AungpaoK/EmbeddedProj/docs/chapter2.md

# บทที่ 2 แนวคิด ทฤษฎี และเอกสารที่เกี่ยวข้อง

บทนี้นำเสนอแนวคิดและหลักการทางวิศวกรรมที่ใช้เป็นพื้นฐานของหุ่นยนต์ส่งอาหาร ตั้งแต่สถาปัตยกรรมระบบฝังตัว การรับสัญญาณจากอุปกรณ์ การควบคุมมอเตอร์ และการประมาณการเคลื่อนที่ ไปจนถึงการตรวจสิ่งกีดขวาง การสื่อสาร และการจัดการลำดับภารกิจ เนื้อหาแต่ละส่วนอธิบายทั้งหลักการทั่วไปและความสัมพันธ์กับการออกแบบที่ปรากฏในฮาร์ดแวร์และซอฟต์แวร์ของโครงงาน เพื่อให้เห็นเหตุผลของการแบ่งหน้าที่และข้อจำกัดของวิธีที่เลือกใช้ รายละเอียดการประกอบ การพัฒนาโปรแกรม และผลการทดสอบเชิงปริมาณนำเสนอในบทที่ 3 และบทที่ 4 ตามลำดับ

## 2.1 ระบบฝังตัวและสถาปัตยกรรมของหุ่นยนต์

### 2.1.1 แนวคิดของระบบฝังตัว

ระบบฝังตัว (embedded system) เป็นระบบคอมพิวเตอร์ที่ออกแบบให้ทำหน้าที่เฉพาะภายใต้ข้อจำกัดของฮาร์ดแวร์และสภาพแวดล้อม เช่น การอ่านค่าจากเซนเซอร์ การประมวลผลตามเงื่อนไข และการสั่งงานอุปกรณ์เอาต์พุต การออกแบบระบบลักษณะนี้จึงพิจารณามากกว่าความถูกต้องของผลลัพธ์ โดยต้องคำนึงถึงเวลาตอบสนอง ความสม่ำเสมอของการทำงาน หน่วยความจำ พลังงาน และการจัดการความผิดพลาดด้วย งานบางประเภทมีข้อกำหนดด้านเวลาจริง (real-time constraint) กล่าวคือ ผลลัพธ์ต้องถูกต้องและเกิดขึ้นภายในเวลาที่กำหนด การพลาดกำหนดเวลาอาจทำให้คุณภาพการควบคุมลดลง แม้ค่าที่คำนวณได้จะถูกต้องก็ตาม

ไมโครคอนโทรลเลอร์รวมหน่วยประมวลผล หน่วยความจำ และวงจรต่อพ่วง เช่น ขารับส่งสัญญาณดิจิทัล (GPIO) ตัวนับเวลา ตัวสร้างสัญญาณ PWM วงจรขัดจังหวะ (interrupt) และพอร์ตสื่อสาร ไว้ในชิปเดียว Arduino Uno R3 ซึ่งใช้ ATmega328P มีทรัพยากรเหล่านี้สำหรับเชื่อมต่ออุปกรณ์และควบคุมงานที่ทำซ้ำตามคาบ [1], [2] ข้อเด่นของแนวทางนี้คือสามารถตอบสนองต่อสัญญาณ encoder และอัปเดตคำสั่งมอเตอร์โดยไม่ต้องผ่านระบบปฏิบัติการทั่วไป ขณะเดียวกันยังต้องจัดสรรขา I/O หน่วยความจำ และเวลาประมวลผลอย่างระมัดระวัง

คอมพิวเตอร์บอร์ดเดี่ยว (single-board computer: SBC) เช่น Raspberry Pi มีทรัพยากรประมวลผลและระบบปฏิบัติการที่เอื้อต่อการทำงานระดับสูง เช่น การจัดการภารกิจ ส่วนติดต่อผู้ใช้ การสื่อสารผ่านเครือข่าย และการประมวลผลข้อมูลจากเซนเซอร์ ระบบปฏิบัติการทั่วไปช่วยให้พัฒนาซอฟต์แวร์ได้สะดวก แต่ไม่ได้รับประกันความหน่วงหรือเวลาตอบสนองแบบกำหนดแน่นอนในทุกสถานการณ์ ด้วยเหตุนี้ การแบ่งงานควบคุมมอเตอร์ที่ต้องอัปเดตต่อเนื่องไปยังไมโครคอนโทรลเลอร์ และให้งานจัดการภารกิจอยู่บน SBC จึงช่วยแยกขอบเขตการทำงานและลดการพึ่งพากันระหว่างซอฟต์แวร์แต่ละระดับ [2]

### 2.1.2 การแบ่งหน้าที่ในโครงงาน

สถาปัตยกรรมหลักประกอบด้วย Raspberry Pi 4 Model B หน่วยความจำ 4 GB และ Arduino Uno R3 หนึ่งบอร์ด Arduino อ่าน encoder และ keypad, ควบคุมมอเตอร์ซ้ายและขวาผ่านวงจรขับ L298N และสั่งแสดงลูกศรเลี้ยวบน LED Matrix ขนาด 32×8 ส่วน Raspberry Pi ทำหน้าที่รัน POS/Kiosk จัดการสถานะภารกิจและ waypoint รับข้อมูล LiDAR และแลกเปลี่ยนคำสั่งหรือข้อมูลสถานะกับ Arduino ผ่าน USB Serial โดยระบบซอฟต์แวร์รองรับทั้ง backend แบบ Serial โดยตรงและ backend ที่ส่งข้อมูลผ่าน ROS 2

การแยกชั้นดังกล่าวทำให้การควบคุมความเร็วล้อ การอ่าน encoder และการสั่งเอาต์พุตอยู่ใกล้ฮาร์ดแวร์ ขณะที่การวางลำดับงานและการติดต่อผู้ใช้อยู่ในซอฟต์แวร์ระดับสูง จอสัมผัสเป็นช่องทางหลักของ POS/Kiosk และ keypad 4×4 เป็นช่องทางรับคำสั่งทางเลือกที่ปรับข้อมูล draft ชุดเดียวกัน ในระบบที่ระบุในเอกสารออกแบบปัจจุบัน ไม่มี Arduino ชั้นวางตัวที่สองหรือเซนเซอร์ IR สำหรับตรวจอาหารโดยตรง การต่อกับชุดชั้นวางเสริมมีทางเลือกในซอฟต์แวร์ แต่ไม่ควรตีความเป็นส่วนหนึ่งของฮาร์ดแวร์ที่ใช้งานอยู่เสมอไป รายละเอียดอุปกรณ์และจุดเชื่อมต่ออ้างอิงได้จาก [แบบออกแบบฮาร์ดแวร์](design.md), [firmware ควบคุมการเคลื่อนที่](../src/Arduino_1_Motion/Arduino_1_Motion.ino) และ [จุดเริ่มต้นระบบหลัก](../src/main.py)

## 2.2 อินพุต เอาต์พุต และการควบคุมมอเตอร์

### 2.2.1 GPIO, interrupt และ PWM

ขา GPIO (general-purpose input/output) ใช้รับหรือส่งสถานะดิจิทัล เช่น อ่านปุ่ม กำหนดทิศทางการหมุน หรือควบคุมสัญญาณ enable การอ่านอินพุตแบบวนตรวจ (polling) เหมาะกับสัญญาณที่เปลี่ยนไม่บ่อย แต่ encoder อาจสร้างพัลส์ต่อเนื่องในขณะที่โปรแกรมทำงานส่วนอื่น วงจร interrupt ช่วยแจ้งให้หน่วยประมวลผลจัดการเหตุการณ์ที่ขาอินพุตเปลี่ยนแปลงโดยไม่ต้องรอรอบการวนตรวจถัดไป จึงลดโอกาสพลาดพัลส์เมื่อเลือกใช้อย่างเหมาะสม [2]

โครงงานใช้ Pin Change Interrupt บนพอร์ต C ของ ATmega328P สำหรับติดตาม encoder โดยนับขอบขาขึ้นของเฟส A และอ่านระดับเฟส B เพื่อระบุทิศทาง การนับใน interrupt ทำให้ตัวแปร tick ถูกเปลี่ยนจากบริบทการทำงานที่ต่างจากลูปหลัก ดังนั้นการคัดลอกค่าตัวนับที่มีขนาดหลายไบต์ต้องป้องกันการอ่านระหว่างที่ interrupt กำลังแก้ค่า firmware จึงอ่านค่า tick โดยปิด interrupt ชั่วคราวขณะคัดลอกข้อมูล แล้วเปิดกลับทันที

การปรับความกว้างพัลส์ (pulse-width modulation: PWM) คือการปรับสัดส่วนเวลาที่สัญญาณอยู่ระดับสูงต่อหนึ่งคาบ หรือ duty cycle เพื่อควบคุมกำลังเฉลี่ยที่ส่งไปยังโหลด ฟังก์ชัน `analogWrite()` ของ Arduino สร้างสัญญาณ PWM บนขาที่รองรับ ไม่ได้สร้างแรงดันแอนะล็อกต่อเนื่องโดยตรง [3] ในโครงงาน PWM ใช้ควบคุมขา enable ของวงจรขับ ส่วนขาดิจิทัลแยกกันใช้กำหนดขั้วและทิศทางของมอเตอร์

### 2.2.2 มอเตอร์กระแสตรงและวงจร H-bridge

มอเตอร์กระแสตรง (direct-current motor: DC motor) เปลี่ยนพลังงานไฟฟ้าเป็นการหมุนของเพลา ความเร็วและแรงบิดที่เกิดขึ้นสัมพันธ์กับแรงดัน กระแส โหลดเชิงกล และคุณสมบัติของมอเตอร์ การกลับขั้วแรงดันที่ขั้วมอเตอร์ทำให้เปลี่ยนทิศการหมุน แต่ขาไมโครคอนโทรลเลอร์ไม่สามารถจ่ายกระแสให้มอเตอร์โดยตรงได้ จึงต้องมีวงจรขับกำลังเป็นตัวกลาง

วงจร H-bridge ใช้ชุดสวิตช์จัดเส้นทางกระแสเพื่อเลือกขั้วแรงดันที่จ่ายให้มอเตอร์ จึงรองรับการหมุนได้สองทิศทาง วงจร L298 เป็นวงจรขับแบบ dual full-bridge สำหรับโหลดเหนี่ยวนำ เช่น มอเตอร์ DC [4] ในระบบนี้ Arduino ส่งสัญญาณกำหนดทิศทางและ PWM ไปยัง L298N เพื่อควบคุมล้อซ้ายและขวาแยกกัน การประเมินกระแสที่รองรับ ความร้อน และแรงดันตกคร่อมของโมดูลต้องอ้างอิง datasheet และการต่อใช้งานจริง ไม่ควรอนุมานจากชื่อโมดูลหรือค่าพิกัดของชิปเพียงอย่างเดียว

### 2.2.3 Encoder และการวัดความเร็ว

Rotary encoder แปลงการหมุนของเพลาเป็นพัลส์ดิจิทัล เมื่อทราบจำนวนพัลส์ต่อรอบและนับการเปลี่ยนแปลงในช่วงเวลาที่กำหนด จะประมาณได้ทั้งระยะทางและความเร็วเชิงเส้นของล้อ สำหรับล้อรัศมี (R) และ encoder ที่ให้ความละเอียด (N) tick ต่อรอบ ระยะทางต่อ tick โดยประมาณเป็น

\[
\Delta s_{tick}=\frac{2\pi R}{N}
\]

หากจำนวน tick เปลี่ยนไป \(\Delta n\) ในช่วงเวลา \(\Delta t\) ระยะทางและความเร็วเฉลี่ยของล้อประมาณได้จาก

\[
\Delta s=\Delta n\,\Delta s_{tick},\qquad v\approx\frac{\Delta s}{\Delta t}
\]

โครงงานกำหนดรัศมีล้อ \(R=0.065\,\mathrm{m}\) และความละเอียด \(N=1920\,\mathrm{tick/rev}\) จึงได้ระยะทางเชิงทฤษฎีประมาณ \(2.13\times10^{-4}\,\mathrm{m/tick}\) หรือประมาณ 0.213 mm ต่อ tick [6], [11] ค่านี้เป็นความสัมพันธ์จากพารามิเตอร์ที่กำหนด ไม่ใช่ผลการวัดความแม่นยำของตัวรถ เนื่องจากค่าจริงยังขึ้นกับความละเอียด encoder การกำหนดขอบสัญญาณใน firmware และลักษณะการสัมผัสระหว่างล้อกับพื้น

### 2.2.4 การควบคุมความเร็วแบบป้อนกลับ

ระบบควบคุมแบบป้อนกลับ (feedback control) นำค่าที่วัดได้กลับมาเปรียบเทียบกับค่าเป้าหมาย แล้วใช้ความคลาดเคลื่อนในการปรับคำสั่งควบคุม ตัวควบคุม PID ประกอบด้วยส่วนสัดส่วน (proportional: P) ส่วนอินทิกรัล (integral: I) และส่วนอนุพันธ์ (derivative: D) สมการในโดเมนเวลาต่อเนื่องเขียนโดยย่อได้ดังนี้ [5]

\[
u(t)=K_p e(t)+K_i\int_0^t e(\tau)\,d\tau+K_d\frac{de(t)}{dt},\qquad e(t)=r(t)-y(t)
\]

โดย \(r(t)\) คือค่าเป้าหมาย \(y(t)\) คือค่าที่วัดได้ และ \(u(t)\) คือคำสั่งควบคุม ส่วน P ตอบสนองต่อความคลาดเคลื่อนปัจจุบัน ส่วน I สะสมความคลาดเคลื่อนตามเวลา และส่วน D พิจารณาอัตราการเปลี่ยนแปลงของความคลาดเคลื่อน การนำ PID ไปใช้บนไมโครคอนโทรลเลอร์เป็นการคำนวณแบบไม่ต่อเนื่อง ณ เวลาสุ่มตัวอย่าง \(T_s\) จึงประมาณอินทิกรัลด้วยผลรวมของตัวอย่างและประมาณอนุพันธ์ด้วยผลต่างระหว่างตัวอย่าง การจำกัดเอาต์พุตและผลรวมอินทิกรัลช่วยลดปัญหา integral windup เมื่อคำสั่งขับถึงขีดจำกัด

firmware ควบคุมความเร็วล้อซ้ายและขวาด้วย PID แยกกัน โดยอัปเดตวงควบคุมประมาณทุก 20 ms หรือ 50 Hz ความเร็วที่คำนวณจาก tick ถูกกรองแบบเอ็กซ์โพเนนเชียลก่อนป้อนกลับ และส่วนอนุพันธ์คำนวณจากการเปลี่ยนแปลงของความเร็วที่วัดได้ เฟิร์มแวร์ยังเพิ่ม feed-forward ตามความเร็วเป้าหมาย และจำกัดผลรวมอินทิกรัลไว้ในช่วงที่กำหนด แนวทางนี้ผสานการชดเชยจากแบบจำลองอย่างง่ายกับการแก้ความคลาดเคลื่อนจากข้อมูล encoder โดยยังต้องอาศัยการตั้งค่าที่เหมาะกับมอเตอร์และโหลดจริง

เมื่อนำหลักการดังกล่าวมาเขียนในรูปแบบไม่ต่อเนื่อง ให้ \(T_s\) เป็นช่วงเวลาสุ่มตัวอย่าง \(v_{raw}[k]\) เป็นความเร็วที่คำนวณจาก tick และ \(v_f[k]\) เป็นความเร็วหลังการกรอง การคำนวณใน firmware สรุปได้โดยประมาณดังนี้

\[
v_f[k]=0.85v_f[k-1]+0.15v_{raw}[k],\quad
e[k]=r[k]-v_f[k]
\]
\[
I[k]=\operatorname{clip}(I[k-1]+e[k]T_s,-2,2),\quad
D_v[k]=\frac{v_f[k]-v_f[k-1]}{T_s}
\]
\[
u[k]=\frac{r[k]}{v_{cruise}}u_{ff}+K_p e[k]+K_i I[k]-K_dD_v[k]
\]

สมการนี้แสดงให้เห็นว่าอนุพันธ์ในโค้ดคำนวณจากความเร็วที่วัดได้ ไม่ได้คำนวณจากผลต่างของ setpoint โดยตรง ส่วนเอาต์พุตสุดท้ายถูกจำกัดให้อยู่ในช่วง PWM ที่ฮาร์ดแวร์รองรับ และมีค่าเอาต์พุตขั้นต่ำเมื่อมีคำสั่งเคลื่อนที่ เพื่อให้คำสั่งไม่หายไปเมื่อผลคำนวณต่ำกว่าค่าที่กำหนด ค่า gain, feed-forward และขีดจำกัดเป็นค่าการตั้งค่าของ firmware ไม่ใช่ค่าทั่วไปที่รับประกันสมรรถนะกับมอเตอร์ทุกชนิด

ขณะเคลื่อนที่ตรง firmware ใช้ความต่างของระยะสะสมระหว่างล้อเป็น wheel synchronization เพื่อปรับ setpoint ของแต่ละล้อและลดการเบี่ยงเบนจากเส้นตรง นอกจากนี้ยังเพิ่มความเร็วเป้าหมายเป็นขั้นในช่วงเริ่มต้นและลดความเร็วเมื่อใกล้ระยะปลายทาง ส่วนการป้องกัน stall จะเพิ่ม PWM เป็นขั้นเมื่อมี setpoint แต่ encoder ไม่แสดงการเคลื่อนที่ และยกสถานะ fault หากไม่มีการเคลื่อนที่ต่อเนื่องเกินช่วงเวลาที่กำหนด กลไกเหล่านี้เป็นส่วนหนึ่งของการควบคุมและการจัดการความผิดปกติใน firmware ไม่ใช่หลักฐานยืนยันความแม่นยำหรือความปลอดภัยของระบบ ผลเชิงปริมาณต้องรายงานจากการทดสอบในบทที่ 4

## 2.3 การเคลื่อนที่แบบ Differential Drive และ Odometry

หุ่นยนต์แบบ Differential Drive ขับเคลื่อนด้วยล้อสองข้างที่ควบคุมความเร็วแยกจากกัน โดยล้อทั้งสองมีแกนหมุนร่วมกันและล้อประคองช่วยพยุงตัวรถ ให้ \(v_L\) และ \(v_R\) เป็นความเร็วเชิงเส้นของล้อซ้ายและขวา และให้ \(b\) เป็นระยะระหว่างศูนย์กลางล้อขับ ความเร็วเชิงเส้นของจุดกึ่งกลางรถ \(v\) และความเร็วเชิงมุมรอบแกนตั้ง \(\omega\) เป็น [11]

\[
v=\frac{v_R+v_L}{2},\qquad
\omega=\frac{v_R-v_L}{b}
\]

เมื่อความเร็วล้อทั้งสองเท่ากัน รถจะเคลื่อนที่ตรงโดยประมาณ เมื่อความเร็วแตกต่างกันรถจะเคลื่อนที่เป็นส่วนโค้ง และเมื่อกำหนดให้ล้อหมุนสวนทางกันด้วยขนาดใกล้เคียงกัน รถจะหมุนรอบตัวเองได้ แบบจำลองนี้ช่วยแปลงคำสั่งการเคลื่อนที่ของรถเป็นความเร็วล้อ และใช้ย้อนคำนวณการเปลี่ยนตำแหน่งจาก encoder อย่างไรก็ตาม แบบจำลองเป็นแบบจำลองเชิงจลนศาสตร์ จึงไม่ได้อธิบายแรง มวล หรือพลวัตของมอเตอร์โดยละเอียด

Odometry คือการประมาณตำแหน่งและทิศทางจากการเคลื่อนที่สะสมของล้อ ในช่วงเวลาหนึ่งให้การเคลื่อนที่ของล้อซ้ายและขวาเป็น \(\Delta s_L\) และ \(\Delta s_R\) จะได้การเคลื่อนที่ของจุดกึ่งกลางและการเปลี่ยน heading ดังนี้

\[
\Delta s=\frac{\Delta s_R+\Delta s_L}{2},\qquad
\Delta\theta=\frac{\Delta s_R-\Delta s_L}{b}
\]

การอินทิเกรตตำแหน่งด้วยวิธี midpoint ประมาณได้จาก

\[
x_{k+1}=x_k+\Delta s\cos(\theta_k+\Delta\theta/2),\quad
y_{k+1}=y_k+\Delta s\sin(\theta_k+\Delta\theta/2),\quad
\theta_{k+1}=\theta_k+\Delta\theta
\]

ในโครงงาน Raspberry Pi ใช้ tick ซ้ายและขวาที่รับจาก Arduino เพื่อคำนวณ pose โดยกำหนดค่ารัศมีล้อ \(R=0.065\,\mathrm{m}\), ระยะห่างล้อ \(b=0.343\,\mathrm{m}\) และความละเอียด \(N=1920\,\mathrm{tick/rev}\) ใน configuration [6], [11] เส้นทางภารกิจใช้ waypoint ที่กำหนดตำแหน่งสถานี ทางแยก และโต๊ะไว้ล่วงหน้า จากนั้นใช้ตำแหน่งและ heading จาก odometry เพื่อควบคุมช่วงทางและการเลี้ยว วิธีนี้มีโครงสร้างตรงไปตรงมาและเหมาะกับเส้นทางที่ทราบรูปแบบ แต่ไม่เทียบเท่ากับการรู้ตำแหน่งสัมบูรณ์ของรถ

กรอบพิกัดของเส้นทางกำหนดสถานีเริ่มต้นเป็น \((0,0)\) และทิศออกจากสถานีเป็นแกน \(+X\) ค่าเริ่มต้นใน configuration กำหนดทางแยกที่ \((2.0,0)\) m และกำหนดตำแหน่งโต๊ะ 1 กับโต๊ะ 2 ที่ \((2.0,+0.6)\) m และ \((2.0,-0.6)\) m ตามลำดับ [config.py](../src/config.py) ตัวควบคุม waypoint ใช้เป้าหมายเหล่านี้เพื่อแยกการเดินทางเป็นช่วงตรงและช่วงปรับ heading โดยใช้ pose ปัจจุบันจาก odometry เป็น feedback เส้นทางจึงเป็นเส้นทางที่ระบุไว้ล่วงหน้า มิใช่การค้นหาเส้นทางอิสระจากแผนที่ในทุกครั้งที่เดินทาง

เนื่องจาก odometry เป็นการคำนวณแบบ dead reckoning ความคลาดเคลื่อนของแต่ละช่วงจะสะสมไปตามระยะทาง ความคลาดเคลื่อนเชิงระบบที่สำคัญ ได้แก่ เส้นผ่านศูนย์กลางล้อซ้ายและขวาไม่เท่ากัน และระยะห่างล้อเชิงประสิทธิผลไม่ตรงกับค่าที่ใช้คำนวณ ส่วนความคลาดเคลื่อนจากการลื่นไถล การกระจายน้ำหนัก และพื้นผิวมีลักษณะเปลี่ยนแปลงตามสภาพการทำงาน งานของ Borenstein และ Feng เสนอวิธีวัดและแก้ความคลาดเคลื่อนเชิงระบบจาก wheelbase และขนาดล้อ จึงสนับสนุนความจำเป็นของการสอบเทียบพารามิเตอร์กับตัวรถจริง [6]

ในเส้นทางซอฟต์แวร์ ROS 2 มีการตั้งค่าปัจจัยปรับระยะล้อเฉพาะการคำนวณ odometry ใน bridge โดยค่าเริ่มต้นของ `ODOM_TRACK_WIDTH_FACTOR` คือ 1.185 ขณะที่ค่าระยะห่างล้อที่ใช้แปลงคำสั่งความเร็วล้อยังคงแยกจากพารามิเตอร์ดังกล่าว [../src/slam_bridge.py](../src/slam_bridge.py) ดังนั้นค่าปรับนี้ควรอธิบายในฐานะการชดเชย odometry ในเส้นทาง ROS ไม่ใช่การเปลี่ยนระยะทางกายภาพของล้อหรือค่าที่ใช้ในทุก backend

แผนที่ร้านอาหารที่ใช้แสดงตำแหน่งและเส้นทางไม่ใช่แหล่ง localization ของ waypoint controller ตามจุดเชื่อมต่อใน [main.py](../src/main.py) ส่วน `slam_bridge.py` เป็น bridge สำหรับส่งข้อมูล encoder เป็น `/odom`, รับคำสั่ง `/cmd_vel` และเชื่อมข้อมูล LiDAR/TF สำหรับการทดสอบที่เกี่ยวข้องกับ ROS 2 และ SLAM การทำงานนำทางของภารกิจจึงควรอธิบายตาม waypoint และ encoder odometry เป็นหลัก ไม่กล่าวว่าใช้ SLAM, A* หรือ DWA เป็นระบบนำทางหลักหากการทดลองนั้นไม่ได้เปิดใช้งานจริง

## 2.4 เซนเซอร์และการตรวจจับสิ่งกีดขวาง

### 2.4.1 Keypad 4×4 และตัวขยายพอร์ต PCF8574

Keypad แบบเมทริกซ์จัดปุ่มเป็นแถวและคอลัมน์เพื่ออ่านปุ่มหลายปุ่มโดยใช้จำนวนสายสัญญาณน้อยกว่าการต่อปุ่มแยกแต่ละปุ่ม ตัวขยายพอร์ต PCF8574 ทำหน้าที่เป็นอินพุต/เอาต์พุตดิจิทัล 8 บิตที่ควบคุมผ่านบัส I²C ซึ่งมีสายสัญญาณข้อมูล SDA และสัญญาณนาฬิกา SCL [10] วิธีนี้ลดจำนวนขา GPIO ที่ใช้กับ keypad และเปิดโอกาสให้ไมโครคอนโทรลเลอร์สงวนขาอื่นไว้สำหรับ encoder และมอเตอร์

โครงงานต่อ SDA และ SCL ของ PCF8574 เข้ากับขา A4 และ A5 ของ Arduino Uno ตามลำดับ กำหนด address เริ่มต้นเป็น `0x20` และกำหนดกลุ่มขา P7–P4 เป็นแถว ส่วน P3–P0 เป็นคอลัมน์ตามการตั้งค่าใน [Arduino1Keypad.h](../src/Arduino_1_Motion/Arduino1Keypad.h) เมื่อพบการกดปุ่ม Arduino ส่งเหตุการณ์ `KEY:<ปุ่ม>` ผ่าน Serial ไปยัง Raspberry Pi แล้วซอฟต์แวร์ POS ตีความตามสถานะภารกิจ ปุ่มจึงเป็นช่องทางป้อนคำสั่ง ไม่ใช่เซนเซอร์ยืนยันว่ามีการวางหรือหยิบอาหารจริง

### 2.4.2 LiDAR และเขตหยุดเพื่อความปลอดภัย

LiDAR แบบระนาบวัดระยะไปยังวัตถุในหลายมุมและส่งผลเป็นชุดข้อมูลเชิงขั้ว ข้อความ `sensor_msgs/LaserScan` ระบุขอบเขตมุม มุมที่เพิ่มต่อหนึ่งตัวอย่าง ช่วงระยะที่ใช้งานได้ และค่าระยะตามลำดับของลำแสง [7] ข้อมูลนี้ใช้ได้ทั้งเพื่อแสดงสภาพแวดล้อม สร้างแผนที่ หรือคัดกรองเขตด้านหน้าสำหรับการหยุด การเลือกใช้ขึ้นกับอัลกอริทึมและวัตถุประสงค์ของระบบ ไม่ได้หมายความว่าการมี LiDAR เพียงอย่างเดียวจะทำให้หุ่นยนต์นำทางหรือหลบสิ่งกีดขวางได้ครบถ้วน

หากให้ระยะของลำแสงตัวที่ \(i\) เป็น \(r_i\) และมุมเป็น \(\phi_i=\text{angle\_min}+i\,\text{angle\_increment}\) จุดวัดในระนาบสามารถเขียนในพิกัดคาร์ทีเซียนได้เป็น \(x_i=r_i\cos\phi_i\) และ \(y_i=r_i\sin\phi_i\) [7] การแปลงนี้ช่วยเชื่อมข้อมูลมุมกับตำแหน่งที่ตรวจพบเมื่อพิจารณาเทียบกับกรอบพิกัดของเซนเซอร์และตัวรถ อย่างไรก็ตาม guard ในโครงงานไม่ได้สร้างวัตถุหรือแผนที่จากจุดเหล่านี้ แต่ใช้มุมและระยะเพื่อคัดกรองจุดที่อยู่ในเขตหยุดเท่านั้น

คลาส `LidarSafetyGuard` ใน [lidar_safety.py](../src/lidar_safety.py) ตรวจเฉพาะกรวยด้านหน้ารถ กรองระยะที่เป็น NaN, infinity หรืออยู่นอกช่วงที่กำหนด และนับจุดที่อยู่ภายในเขตหยุด ค่าเริ่มต้นของซอฟต์แวร์คือกรวยครึ่งมุม 35 องศา ระยะหยุด 0.30 m ระยะใกล้สุดที่พิจารณา 0.22 m และต้องพบอย่างน้อยสามจุดจึงเปลี่ยนสถานะเป็นพบสิ่งกีดขวาง ค่า stop distance ปรับได้จาก environment variable เมื่อ guard รายงานว่ามีสิ่งกีดขวาง waypoint controller จะหยุดคำสั่งเดินหน้าและรอจนเส้นทางกลับมาโล่ง โดยต้องมี ROS 2 และ LiDAR driver ส่งข้อมูล `/scan` ให้ node ที่สมัครรับข้อมูลใน [main.py](../src/main.py)

เงื่อนไขจำนวนจุดช่วยลดการตอบสนองต่อจุดเดี่ยวที่อาจเกิดจากสัญญาณรบกวน แต่ implementation นับจุดที่ผ่านเงื่อนไขทั้งหมดในกรวย ไม่ได้จัดกลุ่มจุดตามวัตถุหรือกำหนดว่าจุดเหล่านั้นต้องติดกันทางมุม ระยะหยุดยังเป็น threshold คงที่ ไม่ได้คำนวณจากความเร็วปัจจุบัน ระยะเบรก หรือความหน่วงของระบบสื่อสาร ดังนั้นคำว่า “หยุดเพื่อความปลอดภัย” ในบริบทนี้หมายถึงการหยุดตามกฎของ virtual bumper ที่กำหนดไว้ ไม่ใช่การรับประกันระยะหยุดภายใต้ทุกสภาพการเคลื่อนที่

กลไกดังกล่าวเป็น virtual bumper ที่ตัดสินใจหยุดจากระยะและจำนวนจุดในเขตที่กำหนด ขอบเขตของมันจึงต่างจากระบบตรวจจับวัตถุ การวางแผนเส้นทางหลบหลีก หรืออุปกรณ์นิรภัยที่ผ่านการรับรอง การประเมินประสิทธิภาพในสภาพใช้งานจริงต้องพิจารณาตำแหน่งติดตั้ง ชนิดพื้นผิว รูปร่างวัตถุ และความเร็วของหุ่นยนต์ร่วมกัน

## 2.5 การสื่อสารและการจัดการสถานะ

### 2.5.1 Serial communication และ ROS 2

การสื่อสารแบบอนุกรม (serial communication) ส่งข้อมูลเป็นลำดับผ่านช่องทางสื่อสาร ผู้ส่งและผู้รับต้องกำหนดอัตราบิตและรูปแบบกรอบข้อมูลให้สอดคล้องกัน Arduino กำหนด baud rate ด้วย `Serial.begin()` [3] ในโครงงานเชื่อม Arduino กับ Raspberry Pi ผ่าน USB Serial ที่ 115200 baud และใช้อักขระขึ้นบรรทัดใหม่เป็นตัวแบ่งข้อความ วิธีแบ่งกรอบด้วย newline ทำให้โปรแกรมปลายทางอ่านข้อมูลทีละบรรทัดและแยกประเภทจากคำนำหน้าได้

ข้อมูลจาก Arduino ประกอบด้วยข้อความ encoder รูปแบบ `ENCODER:<left>,<right>`, สถานะ `STATUS:<สถานะ>` และเหตุการณ์ปุ่ม `KEY:<char>` ส่วนคำสั่งจาก Raspberry Pi ครอบคลุมคำสั่งเดินหน้า เลี้ยว หยุด คำสั่งความเร็วต่อเนื่อง และคำสั่งไฟเลี้ยว เมื่อเลือก backend แบบ ROS 2, `slam_bridge.py` ทำหน้าที่เชื่อมข้อมูล Serial กับ topic เช่น `/cmd_vel`, `/odom` และ `/keypad/key` ส่วน backend แบบ Serial โดยตรงให้ `main.py` และ `odometry.py` อ่านข้อมูลจากพอร์ต Arduino โดยตรง โหมดทั้งสองเป็นทางเลือกในการเชื่อมต่อระดับซอฟต์แวร์ ไม่ใช่ฮาร์ดแวร์ควบคุมสองชุด

การใช้คำนำหน้าและตัวคั่นช่วยให้ parser แยกชนิดข้อความก่อนแปลงค่าภายใน โปรแกรมอ่านข้อมูลจะละเว้นบรรทัดที่ไม่ตรงรูปแบบหรือแปลงเป็นตัวเลขไม่ได้ ส่วน ROS bridge ตรวจว่าข้อมูล encoder ล่าสุดยังสดใหม่ก่อนรายงานสถานะพร้อมรับคำสั่ง กลไกเหล่านี้ช่วยตรวจข้อผิดพลาดเชิงรูปแบบและการขาดข้อมูลได้บางประเภท แต่โปรโตคอลข้อความแบบบรรทัดยังต้องอาศัยการส่งครบถ้วน การใช้ baud rate ตรงกัน และการจัดการกรณีอ่านได้เพียงบางส่วนตามการทำงานของพอร์ต

POS/Kiosk สื่อสารกับ POS Server ผ่าน HTTP และ keypad ส่งเหตุการณ์เข้าสู่ POS Server ผ่านเส้นทางที่เลือกไว้ การใช้ draft ร่วมกันทำให้การป้อนรายการจากจอและ keypad อัปเดตสถานะภารกิจชุดเดียวกัน อย่างไรก็ตาม การทำงานของแต่ละช่องทางขึ้นกับ backend และ node ที่เริ่มทำงาน จึงควรแยกอธิบายช่องทางข้อมูลตามการตั้งค่าที่ใช้ในการสาธิต

### 2.5.2 Finite State Machine และการทำงานตามเวลา

Finite State Machine (FSM) เป็นแบบจำลองที่แทนพฤติกรรมของระบบด้วยชุดสถานะและเงื่อนไขเปลี่ยนสถานะ มีประโยชน์กับงานที่มีลำดับและเงื่อนไขชัดเจน เพราะทำให้ตรวจสอบได้ว่าเหตุการณ์หนึ่งได้รับอนุญาตในสถานะใด และข้อผิดพลาดนำไปสู่สถานะใด ระบบส่งอาหารใช้ FSM ระดับภารกิจสำหรับรับรายการ เริ่มเดินทาง รอผู้ใช้ยืนยันรับอาหาร ตรวจรายการที่เหลือ เดินทางกลับ และจัดการข้อผิดพลาด สถานะในซอฟต์แวร์ภารกิจแยกจากสถานะคำสั่งเคลื่อนที่ใน firmware ซึ่งจัดการคำสั่ง idle, forward, turn และ velocity การแยกสองระดับช่วยไม่ให้รายละเอียดควบคุมมอเตอร์ปะปนกับลำดับการให้บริการ [docs/FSM.md](FSM.md), [delivery_fsm.py](../src/delivery_fsm.py)

ในเชิงแบบจำลอง FSM ระดับภารกิจอธิบายได้ด้วยชุดสถานะ \(S\) เหตุการณ์นำเข้า \(E\) ฟังก์ชันเปลี่ยนสถานะ \(\delta\) และสถานะเริ่มต้น การเปลี่ยนสถานะจะเกิดขึ้นเมื่อระบบได้รับเหตุการณ์ที่เหมาะสมกับสถานะปัจจุบัน เช่น รับภารกิจใหม่เมื่อรอคำสั่ง หรือยืนยันรับอาหารเมื่อถึงช่วงรอรับอาหาร หากการนำทางไม่สำเร็จหรือข้อมูลภารกิจไม่สมบูรณ์ ระบบเปลี่ยนไปสู่สถานะข้อผิดพลาดและสั่งหยุดการเคลื่อนที่ การจัดรูปแบบเช่นนี้ทำให้เงื่อนไขปกติและเงื่อนไขผิดพลาดสามารถตรวจสอบแยกกันได้ ทั้งยังช่วยให้การทดสอบภารกิจจำลองลำดับเหตุการณ์ของผู้ใช้ได้โดยไม่ต้องพึ่งวงจรมอเตอร์ทุกกรณี

การทำงานตามคาบใน firmware อาศัย `millis()` เพื่อตรวจว่าเวลาผ่านไปถึงรอบควบคุมหรือยัง โดยตั้งรอบควบคุมมอเตอร์ไว้ประมาณ 20 ms และส่งค่า encoder ทุก 100 ms การจัดรอบแบบนี้ช่วยให้ลูปเดียวอัปเดตมอเตอร์ อ่านอินพุต และส่งข้อมูลเป็นระยะได้ แต่ไม่ได้รับประกันว่าทุกส่วนของลูปไม่บล็อก เพราะ firmware ยังเรียก `Serial.readStringUntil('\n')` ซึ่งรออักขระขึ้นบรรทัดใหม่หรือ timeout ก่อนคืนค่า ดังนั้นควรอธิบายว่ามีการจัดรอบงานด้วยเวลา ไม่ใช่ระบบที่ปลอดการรอคอยทุกเส้นทาง [3]

ระบบยังใช้ watchdog, timeout และสถานะ fault เพื่อจัดการกรณีข้อมูลหรือการเคลื่อนที่ขาดหาย ตัวอย่างเช่น คำสั่งความเร็วต่อเนื่องถูกตัดเมื่อไม่มีคำสั่งใหม่ภายในช่วงเวลาที่ตั้งไว้ และกรณี encoder ไม่รายงานความคืบหน้าจะนำไปสู่การเพิ่มแรงขับแบบจำกัดหรือหยุดพร้อมสถานะผิดพลาด การมีกลไกเหล่านี้ทำให้พฤติกรรมผิดปกติมีทางจัดการที่ระบุได้ แต่ผลการตรวจจับและเวลาตอบสนองยังต้องประเมินจากการทดสอบจริง

## 2.6 ระบบจ่ายไฟและวงจรขับกำลัง

แหล่งจ่ายหลักของหุ่นยนต์เป็นแบตเตอรี่ลิเธียม 12 V 15 Ah พร้อมสวิตช์และ bus bar สำหรับกระจายไฟ วงจร L298N ใช้ขับมอเตอร์ ส่วนตัวแปลง DC-DC แบบ buck และตัวแปลง DC-DC แบบอะแดปเตอร์ที่ติดตั้งอยู่ทำหน้าที่ปรับระดับแรงดันให้เหมาะกับอุปกรณ์อิเล็กทรอนิกส์ การแยกหน้าที่ระหว่างแหล่งจ่ายมอเตอร์กับวงจรควบคุมเป็นประเด็นที่ควรพิจารณา เนื่องจากมอเตอร์เป็นโหลดที่มีกระแสเปลี่ยนแปลงตามภาระและอาจทำให้แรงดันของระบบเปลี่ยนได้

การประเมินภาระทางไฟฟ้าเบื้องต้นพิจารณากำลังจากความสัมพันธ์ \(P=VI\) และพลังงานจากผลคูณของกำลังกับเวลา สำหรับแบตเตอรี่ที่ระบุ 12 V และ 15 Ah ผลคูณเชิงนามเป็น 180 Wh โดยประมาณภายใต้เงื่อนไขพิกัด อย่างไรก็ดี ค่านี้ไม่ใช่พลังงานที่ใช้ได้จริงทั้งหมดและไม่เพียงพอที่จะระบุระยะเวลาทำงาน เพราะขึ้นกับประสิทธิภาพตัวแปลง กระแสของมอเตอร์และคอมพิวเตอร์ ภาระหน้าจอ และเงื่อนไขการคายประจุ เนื้อหาในบทนี้จึงใช้ค่าพิกัดเพื่ออธิบายการจัดระบบ ไม่สรุป runtime โดยไม่มีการวัดโหลดจริง

ข้อมูลรายการอุปกรณ์ยืนยันการมีแบตเตอรี่ ตัวแปลง และวงจรขับ แต่ไม่ได้ระบุแรงดันเอาต์พุตหรือสาขาการจ่ายไฟของอุปกรณ์ทุกชิ้น การอธิบายการต่อจริงจึงต้องอ้างอิงผังวงจรหรือการวัดจากชุดประกอบ ไม่อนุมานแรงดันของแต่ละบอร์ดจากพิกัดชื่อโมดูลเพียงอย่างเดียว นอกจากนี้ ความจุแบตเตอรี่ที่ระบุไม่เพียงพอสำหรับสรุประยะเวลาทำงาน หากไม่มีข้อมูลการใช้กระแสของระบบและเงื่อนไขการทดสอบ

## 2.7 งานวิจัยและโครงงานที่เกี่ยวข้อง

งานที่เกี่ยวข้องครอบคลุมพื้นฐานการเคลื่อนที่ของหุ่นยนต์ล้อ การลดความคลาดเคลื่อนของ odometry และระบบบริการที่ใช้ LiDAR สำหรับการทำแผนที่หรือนำทาง งานเหล่านี้ให้กรอบเปรียบเทียบทั้งด้านวิธีการและขอบเขตการทำงาน โดยไม่ถือว่าวิธีที่ปรากฏในงานอ้างอิงเป็นความสามารถของหุ่นยนต์โครงงานนี้โดยอัตโนมัติ

| งานที่เกี่ยวข้อง | แนวทางสำคัญ | ความเชื่อมโยงและขอบเขตเมื่อเทียบกับโครงงาน |
|---|---|---|
| Siegwart, Nourbakhsh และ Scaramuzza (2011), พื้นฐานหุ่นยนต์เคลื่อนที่ [11] | อธิบายกลไกการเคลื่อนที่ แบบจำลองเชิงจลนศาสตร์ การรับรู้ ตำแหน่ง และการวางแผนการเคลื่อนที่ของหุ่นยนต์เคลื่อนที่ | ใช้เป็นกรอบทฤษฎีสำหรับแบบจำลอง Differential Drive และการประมาณการเคลื่อนที่ของล้อ ส่วนโครงงานประยุกต์แบบจำลองกับล้อ encoder และเส้นทาง waypoint ที่กำหนดไว้ |
| Borenstein และ Feng (1996), การวัดและแก้ความคลาดเคลื่อน odometry [6] | วิเคราะห์ความคลาดเคลื่อนเชิงระบบจากเส้นผ่านศูนย์กลางล้อที่ต่างกันและระยะห่างล้อเชิงประสิทธิผล พร้อมเสนอวิธีสอบเทียบ | ใช้สนับสนุนข้อจำกัดของ dead reckoning และความจำเป็นในการตรวจสอบพารามิเตอร์ของรถจริง โดยผลการสอบเทียบของงานดังกล่าวไม่ใช่ผลการทดลองของโครงงานนี้ |
| Yang (2021), หุ่นยนต์ภายในอาคารด้วย ROS และ LiDAR [8] | ใช้ LiDAR สองมิติและ particle-filter SLAM เพื่อสร้างแผนที่ ใช้ A* และ DWA สำหรับนำทาง และตรวจสอบระบบในสภาพแวดล้อมจำลอง | เกี่ยวข้องกับ ROS และ LiDAR แต่โครงงานใช้ encoder odometry กับ waypoint เป็นหลัก ส่วน LiDAR safety guard ใช้หยุดในเขตด้านหน้า จึงไม่ควรกล่าวว่าใช้ A*, DWA หรือ SLAM localization ในภารกิจหลัก |
| Nguyen และ Nguyen (2025), หุ่นยนต์บริการในร้านอาหารด้วย LiDAR-SLAM [9] | ผสาน LiDAR, wheel encoder, accelerometer และ gyroscope สำหรับ localization/SLAM และกล่าวถึงการปรับเส้นทางเมื่อพบสิ่งกีดขวาง | มีบริบทการใช้งานใกล้เคียงกัน แต่ระบบดังกล่าวมุ่ง sensor fusion และ localization ขณะที่โครงงานนี้เน้นการบูรณาการระบบควบคุมระดับล่างกับการจัดภารกิจและการเดินทางตามเส้นทางที่กำหนด |

จากการสังเคราะห์ งานอ้างอิงแสดงให้เห็นแนวทางตั้งแต่การใช้ odometry เป็นฐานคำนวณตำแหน่ง ไปจนถึงการเพิ่มข้อมูลเซนเซอร์ภายนอกและ SLAM เพื่อแก้ข้อจำกัดของการสะสมความคลาดเคลื่อน โครงงานนี้อยู่ในขอบเขตการประยุกต์ระบบฝังตัวหลายระดับ ได้แก่ การควบคุมมอเตอร์ด้วย encoder การสื่อสารกับคอมพิวเตอร์ระดับสูง การรับคำสั่งจาก POS/Kiosk และการหยุดเมื่อ LiDAR ตรวจพบวัตถุในเขตที่กำหนด จึงเป็นการบูรณาการองค์ประกอบเหล่านี้ในเส้นทางส่งอาหารที่กำหนดไว้ ไม่ใช่การเสนออัลกอริทึม SLAM หรือการวางแผนเส้นทางทั่วไปขึ้นใหม่

## 2.8 สรุป

บทนี้อธิบายพื้นฐานระบบฝังตัวและการแบ่งงานระหว่าง Arduino กับ Raspberry Pi หลักการอ่าน encoder ด้วย interrupt การควบคุมมอเตอร์ผ่าน PWM และ H-bridge ตลอดจนวงควบคุม PID และการซิงโครไนซ์ล้อ นอกจากนี้ยังอธิบายแบบจำลอง Differential Drive การคำนวณ odometry และแหล่งความคลาดเคลื่อนที่ทำให้ตำแหน่งแบบ dead reckoning สะสม drift ได้ หลักการของ I²C keypad, LiDAR safety guard, Serial/ROS 2 และ FSM แสดงให้เห็นเส้นทางข้อมูลตั้งแต่ผู้ใช้และเซนเซอร์จนถึงการควบคุมการเคลื่อนที่

การเชื่อมโยงทฤษฎีกับระบบจริงยังชี้ให้เห็นขอบเขตที่ควรรักษาไว้ในการอธิบายผลของโครงงาน ได้แก่ การเดินทางตาม waypoint ที่กำหนดไว้ การใช้ encoder odometry เป็นข้อมูลตำแหน่ง การใช้ LiDAR guard เพื่อหยุดในเขตจำกัด และการยืนยันอาหารโดยผู้ใช้ผ่าน POS/Kiosk หรือ keypad ส่วนผลด้านความแม่นยำ การตอบสนอง และความปลอดภัยต้องนำเสนอจากผลการทดสอบในบทที่ 4

## เอกสารอ้างอิง

[1] Arduino, “UNO R3,” *Arduino Documentation*. [ออนไลน์]. เข้าถึงได้จาก: https://docs.arduino.cc/hardware/uno-rev3/

[2] Microchip Technology, “ATmega328P 8-bit AVR Microcontroller Datasheet.” [ออนไลน์]. เข้าถึงได้จาก: https://www.microchip.com/en-us/product/atmega328

[3] Arduino, “Arduino Language Reference: `analogWrite()`, `Serial.begin()`, และ `millis()`.” [ออนไลน์]. เข้าถึงได้จาก: https://docs.arduino.cc/language-reference/en/functions/analog-io/analogWrite/ ; https://docs.arduino.cc/language-reference/en/functions/communication/serial/begin/ ; https://docs.arduino.cc/language-reference/en/functions/time/millis/

[4] STMicroelectronics, “L298: Dual Full-Bridge Driver.” [ออนไลน์]. เข้าถึงได้จาก: https://www.st.com/en/motor-drivers/l298.html

[5] K. J. Åström and R. M. Murray, “PID Control,” in *Feedback Systems: An Introduction for Scientists and Engineers*. California Institute of Technology. [ออนไลน์]. เข้าถึงได้จาก: https://www.cds.caltech.edu/~murray/FBS/PID_Control.html

[6] J. Borenstein and L. Feng, “Measurement and Correction of Systematic Odometry Errors in Mobile Robots,” *IEEE Transactions on Robotics and Automation*, vol. 12, no. 6, pp. 869–880, 1996. doi: 10.1109/70.544770.

[7] Open Robotics, “sensor_msgs/msg/LaserScan,” *ROS 2 Message Documentation*. [ออนไลน์]. เข้าถึงได้จาก: https://docs.ros2.org/galactic/api/sensor_msgs/msg/LaserScan.html

[8] X. Yang, “Slam and navigation of indoor robot based on ROS and lidar,” *Journal of Physics: Conference Series*, vol. 1748, 022038, 2021. doi: 10.1088/1742-6596/1748/2/022038.

[9] D. D. Nguyen and V. P. Nguyen, “Design of a service robot for restaurant applications using Lidar-Based SLAM localization,” *Journal of Measurement, Control and Automation*, vol. 29, no. 3, pp. 42–50, 2025. doi: 10.64032/mca.v29i3.319.

[10] NXP Semiconductors, “PCF8574; PCF8574A: Remote 8-bit I/O expander for I²C-bus with interrupt,” datasheet, Rev. 5, 2013. [ออนไลน์]. เข้าถึงได้จาก: https://www.nxp.com/documents/data_sheet/PCF8574_PCF8574A.pdf

[11] R. Siegwart, I. R. Nourbakhsh, and D. Scaramuzza, *Introduction to Autonomous Mobile Robots*, 2nd ed. Cambridge, MA: MIT Press, 2011. https://mitpress.mit.edu/9780262015356/introduction-to-autonomous-mobile-robots/
