AungpaoK/EmbeddedProj/docs/report/รายงาน embeded proj full.docx

รายงาน

Mini project วิชา 240-319 Embedded System Developer Module

หุ่นยนต์เสิร์ฟอาหารอัจฉริยะ Smart Food Delivery Robot

จัดทำโดย

นายธีรภัทร | ภักดี | รหัสนักศึกษา | 6710110199 | Section 01
นายพัทธรินทร์ | กิตติพุฒิพงศ์ | รหัสนักศึกษา | 6710110282 | Section 01
นายสรวิศ | สุขการณ์ | รหัสนักศึกษา | 6710110428 | Section 01

เสนอ

รศ.ดร. | ปัญญยศ | ไชยกาฬ
ผศ.ดร. | วชรินทร์ | แก้วอภิชัย
รศ.ดร. | ทวีศักดิ์ | เรืองพีระกุล

รายงานฉบับนี้เป็นส่วนหนึ่งของรายวิชา

240-319 ชุดวิชานักพัฒนาระบบฝังตัว (EMBEDDED SYSTEM DEVELOPER MODULE)

มหาวิทยาลัยสงขลานครินทร์ วิทยาเขตหาดใหญ่

ภาคเรียนที่ 1 ปี การศึกษา 2569

# คำนำ

รายงานฉบับนี้เป็นส่วนหนึ่งของรายวิชา 240-319 ชุดวิชานักพัฒนาระบบฝังตัว (Embedded System Developer Module) จัดทำขึ้นเพื่อศึกษา ออกแบบ และพัฒนาระบบสมองกลฝังตัวที่สามารถนำไปประยุกต์ใช้งานได้จริง การจัดทำโครงงานในครั้งนี้ช่วยให้ผู้จัดทำได้ฝึกทักษะการปฏิบัติ พร้อมทั้งเสริมสร้างความรู้และความเข้าใจในเนื้อหาของรายวิชาให้ชัดเจนมากยิ่งขึ้นทั้งในด้านทฤษฎีและการนำไปประยุกต์ใช้จริง

คณะผู้จัดทำหวังเป็นอย่างยิ่งว่ารายงานฉบับนี้จะเป็นประโยชน์แก่ผู้อ่านหรือนักศึกษาที่กำลังศึกษาข้อมูลเกี่ยวกับการพัฒนาระบบ Embedded System หากมีข้อเสนอแนะหรือข้อผิดพลาดประการใด คณะผู้จัดทำขอน้อมรับคำแนะนำและขออภัยมา ณ ที่นี้ด้วย

คณะผู้จัดทำ

# สารบัญ

# บทที่ 1 บทนำ

## 1.1 ที่มาและความสำคัญ

ธุรกิจอาหารและเครื่องดื่มเป็นภาคธุรกิจที่มีความสำคัญต่อเศรษฐกิจไทย โดยข้อมูลธุรกิจอาหาร และเครื่องดื่มที่จดทะเบียนกับกรมพัฒนาธุรกิจการค้าในปี 2567 มีรายได้รวมประมาณ 337.2 พันล้านบาท และธุรกิจร้านอาหารมีรายได้ประมาณ 308.8 พันล้านบาท หรือคิดเป็นร้อยละ 91.6 ของรายได้ธุรกิจอาหาร และเครื่องดื่มที่จดทะเบียนทั้งหมด ขณะเดียวกัน สำนักงานนโยบายและยุทธศาสตร์การค้ารายงานว่า ตลาดหุ่นยนต์บริการในประเทศไทยเติบโตกว่าร้อยละ 147.8 ในปี 2565 มีหุ่นยนต์บริการที่ใช้งานจริงมากกว่า 1,660 ตัว และคาดการณ์ว่าจะเพิ่มเป็น 2,270 ตัวในปี 2567 ตัวเลขเหล่านี้สะท้อนให้เห็นถึงขนาดของ อุตสาหกรรมอาหารและแนวโน้มการประยุกต์ใช้เทคโนโลยีเพื่อสนับสนุนการให้บริการ อย่างไรก็ตามจากการ ศึกษายังพบปัญหาการบริการในร้านอาหารขนาดเล็กได้ เช่น การนำอาหารจากครัวไปส่งยังโต๊ะลูกค้ายังคง เป็นงานที่ต้องทำซ้ำและอาจเกิดความล่าช้าหรือความผิดพลาดได้ โดยเฉพาะในช่วงที่มีผู้ใช้บริการจำนวนมาก จึงมีความสนใจในการนำระบบอัตโนมัติมาช่วยสนับสนุนการขนส่งอาหารภายในร้าน

ระบบสมองกลฝังตัว (Embedded System) และระบบอัตโนมัติ (Automation) มีบทบาทสำคัญ ต่อการดำเนินชีวิตและการพัฒนาเศรษฐกิจในสังคมปัจจุบัน ระบบสมองกลฝังตัวช่วยให้อุปกรณ์ต่าง ๆ สามารถรับข้อมูลจากสภาพแวดล้อม ประมวลผลข้อมูล และตอบสนองตามเงื่อนไขที่กำหนดได้อย่างเหมาะสม ขณะที่ระบบอัตโนมัติช่วยลดขั้นตอนการทำงานที่ซ้ำซ้อน เพิ่มความสม่ำเสมอในการปฏิบัติงาน และสนับสนุน การทำงานที่ต้องการความรวดเร็วหรือความต่อเนื่อง เทคโนโลยีทั้งสองจึงถูกนำไปประยุกต์ใช้ในหลายด้าน เช่น อุตสาหกรรม การแพทย์ การคมนาคม เกษตรกรรม บ้านอัจฉริยะ และธุรกิจบริการ นอกจากช่วยเพิ่ม ประสิทธิภาพของกระบวนการทำงานแล้ว ยังช่วยให้มนุษย์สามารถมุ่งเน้นงานที่ต้องใช้การตัดสินใจ การดูแล ผู้รับบริการ และความคิดสร้างสรรค์ได้มากขึ้น การออกแบบระบบดังกล่าวจึงควรคำนึงถึงความถูกต้อง ความปลอดภัย ความน่าเชื่อถือ ต้นทุน และความเหมาะสมกับบริบทการใช้งาน

จากความสำคัญของปัญหาและบทบาทของเทคโนโลยีดังกล่าว คณะผู้จัดทำจึงสนใจพัฒนาต้นแบบ หุ่นยนต์ส่งอาหารอัตโนมัติสำหรับช่วยลำเลียงอาหารภายในพื้นที่จำลอง โดยมุ่งประยุกต์ใช้ความรู้ ในขอบเขต ของวิชา Embedded System Developer Module ได้แก่ ระบบสมองกลฝังตัว การควบคุมอุปกรณ์ การ สื่อสารระหว่างระบบ การตรวจจับสภาพแวดล้อม และการนำทางอัตโนมัติ โครงงานนี้จึงเป็นแนวทางสำหรับ ศึกษาและบูรณาการเทคโนโลยีที่เกี่ยวข้องกับการพัฒนาระบบอัตโนมัติในงานบริการ

## 1.2 วัตถุประสงค์

เพื่อศึกษาการประยุกต์ใช้ความรู้จากวิชา 240-319 Embedded System Developer Module มาสร้างต้นแบบหุ่นยนต์ส่งอาหาร (Food Delivery Robot) สำหรับร้านอาหารขนาดเล็ก

## 1.3 ขอบเขตของโครงงาน

โครงงานนี้ครอบคลุมการออกแบบและพัฒนาหุ่นยนต์ส่งอาหารต้นแบบ -ขับเคลื่อนแบบ Differential Drive เหมาะสมสำหรับร้านอาหารขนาดเล็ก โดยทดสอบในพื้นที่จำลองภายในอาคารและใช้เส้นทางกับ ตำแหน่งที่ กำหนดไว้ล่วงหน้า ระบบรองรับการเลือกชั้นวางและโต๊ะปลายทางผ่านระบบ POS หรือ Keypad รวมถึงการ ควบคุมการเคลื่อนที่ การสื่อสารระหว่างระบบ การตรวจจับสิ่งกีดขวาง การสื่อสารระหว่างอุปกรณ์ และการเคลื่อนที่ในพื้นที่จำลอง

## 1.4 ประโยชน์ที่คาดว่าจะได้รับ

1. ได้ต้นแบบหุ่นยนต์ส่งอาหารอัตโนมัติสำหรับทดสอบการทำงานในพื้นที่จำลอง เพื่อแก้ปัญหาการ บริการของพนักงานเสิร์ฟอาหาร
2. ได้ศึกษาแนวทางการประยุกต์ใช้ระบบสมองกลฝังตัวและระบบอัตโนมัติกับงานบริการ การการควบคุม การสื่อสาร การตรวจจับสภาพแวดล้อม และการนำทางอัตโนมัติ
3. ได้แนวทางสำหรับพัฒนาระบบช่วยขนส่งอาหารในร้านอาหารขนาดเล็ก
4. ได้พื้นฐานสำหรับการพัฒนาหุ่นยนต์บริการที่มีความสามารถสูงขึ้นในอนาคต

## 1.5 นิยามศัพท์เฉพาะ

ระบบสมองกลฝังตัว (Embedded System) หมายถึง ระบบคอมพิวเตอร์ที่ออกแบบให้ทำงานเฉพาะด้าน โดยสามารถรับข้อมูล ประมวลผล และควบคุมอุปกรณ์ตามวัตถุประสงค์ที่กำหนด

ระบบอัตโนมัติ (Automation) หมายถึง การใช้ระบบควบคุมและเทคโนโลยีเพื่อให้กระบวนการทำงาน ดำเนินไปตามเงื่อนไขที่กำหนด โดยลดการควบคุมจากมนุษย์ในขั้นตอนที่ทำซ้ำ

หุ่นยนต์ส่งอาหาร (Food Delivery Robot) หมายถึง หุ่นยนต์บริการที่ใช้ช่วยลำเลียงอาหารจากจุดเตรียมอาหารไปยังจุดหมายภายในพื้นที่ที่กำหนด

Differential Drive หมายถึง รูปแบบการขับเคลื่อนที่ควบคุมความเร็วของล้อซ้ายและล้อขวาแยกจากกัน เพื่อกำหนดทิศทางและการหมุนของหุ่นยนต์

Waypoint หมายถึง จุดตำแหน่งหรือจุดอ้างอิงที่กำหนดไว้บนเส้นทาง เพื่อใช้ควบคุมลำดับการเดินทางของ หุ่นยนต์

Encoder หมายถึง อุปกรณ์ที่ตรวจวัดการหมุนหรือการเคลื่อนที่ของมอเตอร์และแปลงเป็นสัญญาณสำหรับ ใช้ประเมินระยะทางหรือความเร็ว

LiDAR หมายถึง เซนเซอร์ที่ใช้แสงเลเซอร์วัดระยะห่างจากวัตถุ เพื่อรับรู้สภาพแวดล้อมและตรวจจับสิ่ง กีดขวาง

ROS 2 หมายถึง เฟรมเวิร์กสำหรับพัฒนาซอฟต์แวร์หุ่นยนต์และแลกเปลี่ยนข้อมูลระหว่างส่วนต่าง ๆ ของระบบ

SLAM หมายถึง กระบวนการที่หุ่นยนต์สร้างแผนที่ของพื้นที่พร้อมประมาณตำแหน่งของตนเองขณะเคลื่อนที่

POS/Kiosk หมายถึง ส่วนติดต่อผู้ใช้สำหรับรับรายการอาหาร เลือกจุดหมาย และจัดการข้อมูลภารกิจของหุ่นยนต์

# บทที่ 2 แนวคิด ทฤษฎี และเอกสารที่เกี่ยวข้อง

บทนี้นำเสนอแนวคิดและหลักการทางวิศวกรรมที่ใช้เป็นพื้นฐานในการออกแบบหุ่นยนต์ส่งอาหาร ครอบคลุมสถาปัตยกรรมระบบฝังตัว การรับสัญญาณ การควบคุมมอเตอร์ การประมาณตำแหน่ง การตรวจสิ่ง กีดขวาง การสื่อสาร และการจัดการภารกิจ แต่ละหัวข้ออธิบายหลักการพร้อมเชื่อมโยงกับระบบของโครงงาน เพื่อให้เห็นหน้าที่และข้อจำกัดของแนวทางที่เลือก

## 2.1 ระบบฝังตัวและสถาปัตยกรรมของหุ่นยนต์

### 2.1.1 แนวคิดของระบบฝังตัว

ระบบฝังตัว (embedded system) คือระบบคอมพิวเตอร์ที่ออกแบบให้ทำงานเฉพาะด้านภายใต้ ข้อจำกัดของอุปกรณ์และสภาพแวดล้อม ตัวอย่างงาน ได้แก่ การอ่านสัญญาณจากเซนเซอร์ การประมวลผล ตามเงื่อนไข และการควบคุมอุปกรณ์เอาต์พุต การออกแบบจึงต้องคำนึงถึงความถูกต้องของผลลัพธ์ เวลา ตอบสนอง ความสม่ำเสมอในการทำงาน ทรัพยากรหน่วยความจำและพลังงาน การจัดการเมื่อเกิดข้อผิดพลาด สำหรับงานที่มีข้อกำหนดด้านเวลาจริง (real-time constraint) ผลลัพธ์ต้องถูกต้องและเกิดขึ้นภายในเวลา ที่กำหนด หากพลาดกำหนดเวลา คุณภาพการควบคุมอาจลดลง แม้ค่าที่คำนวณได้จะถูกต้อง

ไมโครคอนโทรลเลอร์รวมหน่วยประมวลผล หน่วยความจำ และวงจรต่อพ่วง เช่น ขารับส่งสัญญาณ ดิจิทัล (GPIO) ตัวนับเวลา ตัวสร้างสัญญาณ PWM วงจรขัดจังหวะ (interrupt) และพอร์ตสื่อสารไว้ในชิปเดียว Arduino Uno R3 ซึ่งใช้ ATmega328P ดังรูปที่ 1 ตัว Arduino มีทรัพยากรเหล่านี้สำหรับเชื่อมต่ออุปกรณ์ และควบคุมงานตามคาบ การควบคุมงานระดับล่างโดยไม่ต้องพึ่งระบบปฏิบัติการทั่วไปช่วยให้ตอบสนองต่อ สัญญาณ encoder และอัปเดตคำสั่งมอเตอร์ได้โดยตรง อย่างไรก็ตาม ผู้ออกแบบยังต้องจัดสรรขา I/O หน่วยความจำ และเวลาประมวลผลให้เหมาะสม

คอมพิวเตอร์บอร์ดเดี่ยว (single-board computer: SBC) เช่น Raspberry Pi ตัวอย่างดังรูปที่ 2 มีทรัพยากรประมวลผลและระบบปฏิบัติการที่เอื้อต่องานระดับสูง เช่น การจัดการภารกิจ ส่วนติดต่อผู้ใช้ การสื่อสารผ่านเครือข่าย และการประมวลผลข้อมูลจากเซนเซอร์ แม้ระบบปฏิบัติการทั่วไปจะช่วยให้พัฒนา ซอฟต์แวร์ได้สะดวก แต่ก็ไม่ได้รับประกันความหน่วงหรือเวลาตอบสนองที่แน่นอนในทุกสถานการณ์ การ มอบหมายงานควบคุมมอเตอร์ที่ต้องอัปเดตต่อเนื่องให้ไมโครคอนโทรลเลอร์ และให้งานจัดการภารกิจอยู่บน SBC จึงช่วยแยกขอบเขตและลดการพึ่งพากันระหว่างซอฟต์แวร์แต่ละระดับ


รูปที่ 1 บอร์ด Arduino UNO R3 ที่ใช้ ATmega328P เป็นตัวประมวลผลหลัก
(ที่มา: https://en.wikipedia.org/wiki/Arduino_Uno)


รูปที่ 2 บอร์ด Raspberry Pi 4
(ที่มา: https://en.wikipedia.org/wiki/Arduino_Uno)

### 2.1.2 การจัดการงานของระบบหุ่นยนต์

ระบบประกอบด้วย Raspberry Pi 4 Model B หน่วยความจำ 4 GB และ Arduino Uno R3 หนึ่งบอร์ด Arduino อ่านค่า encoder และ keypad ควบคุมมอเตอร์ซ้ายและขวาผ่านวงจรขับ L298N และ สั่งแสดงลูกศรเลี้ยวผ่าน LED Matrix ขนาด 32×8 ส่วน Raspberry Pi ทำงาน POS/Kiosk จัดการสถานะ ภารกิจและตำแหน่ง waypoint รับข้อมูล LiDAR และแลกเปลี่ยนคำสั่งหรือข้อมูลสถานะกับ Arduino ผ่าน USB Serial ซอฟต์แวร์รองรับการเชื่อมต่อสองรูปแบบ ได้แก่ Serial โดยตรงและการส่งข้อมูลผ่าน ROS 2

การแบ่งหน้าที่นี้ทำให้งานควบคุมระดับใกล้ฮาร์ดแวร์ เช่น การอ่าน encoder และการควบคุม ความเร็วล้อ อยู่บน Arduino ขณะที่การจัดลำดับภารกิจและการติดต่อผู้ใช้อยู่บน Raspberry Pi จอสัมผัส เป็นช่องทางหลักของ POS/Kiosk ส่วน keypad 4×4 เป็นช่องทางเพิ่มเติมที่ใช้งานทดแทนกันได้

## 2.2 อินพุต เอาต์พุต และการควบคุมมอเตอร์

### 2.2.1 GPIO, interrupt และ PWM

ขา GPIO (general-purpose input/output) ใช้รับหรือส่งสถานะดิจิทัล เช่น อ่านปุ่มกำหนดทิศทาง การหมุน หรือควบคุมสัญญาณ enable การอ่านอินพุตแบบวนตรวจ (polling) เหมาะกับสัญญาณที่เปลี่ยนไม่ บ่อย แต่ encoder อาจสร้างพัลส์ต่อเนื่องระหว่างที่โปรแกรมทำงานส่วนอื่น วงจร interrupt แจ้งให้หน่วย ประมวลผลจัดการเหตุการณ์เมื่อสถานะขาอินพุตเปลี่ยน โดยไม่ต้องรอรอบตรวจถัดไป จึงช่วยลดโอกาสพลาด พัลส์เมื่อเลือกใช้อย่างเหมาะสม

โครงงานใช้ Pin Change Interrupt บนพอร์ต C ของ ATmega328P เพื่อติดตามสัญญาณ encoder โดยนับขอบขาขึ้นของเฟส A และอ่านระดับสัญญาณเฟส B เพื่อระบุทิศทาง เนื่องจาก interrupt และลูปหลักเข้าถึงตัวแปร tick ร่วมกัน การอ่านตัวแปรหลายไบต์จึงต้องป้องกันไม่ให้ค่าเปลี่ยนระหว่างคัดลอก ในโครงงาน firmware จึงปิด interrupt ชั่วคราวขณะอ่านค่า แล้วเปิดใช้งานอีกครั้งทันที

การปรับความกว้างพัลส์ (pulse-width modulation: PWM) เป็นการปรับสัดส่วนเวลาที่สัญญาณ อยู่ในระดับสูงต่อหนึ่งคาบ หรือ duty cycle เพื่อควบคุมกำลังเฉลี่ยที่ส่งไปยังโหลด ฟังก์ชัน analogWrite() ของ Arduino สร้างสัญญาณ PWM บนขาที่รองรับ ไม่ได้สร้างแรงดันแอนะล็อกต่อเนื่องโดยตรง ในโครงงาน ใช้ PWM ควบคุมขา enable ของวงจรขับ ส่วนขาดิจิทัลแยกกันใช้กำหนดขั้วและทิศทางการหมุนของมอเตอร์

Basics of PWM (Pulse Width Modulation) | Arduino Documentation

รูปที่ 3 ตัวอย่างการส่ง PWM ในระดับ Duty Cycle ต่าง ๆ
(ที่มา: https://docs.arduino.cc/learn/microcontrollers/analog-output/)

### 2.2.2 มอเตอร์กระแสตรงและวงจร H-bridge

มอเตอร์กระแสตรง (direct-current motor: DC motor) เปลี่ยนพลังงานไฟฟ้าให้เป็นการหมุนของ เพลา ความเร็วและแรงบิดขึ้นอยู่กับแรงดัน กระแส โหลดเชิงกล และคุณสมบัติของมอเตอร์ การกลับขั้วแรง ดันที่ขั้วมอเตอร์ทำให้ทิศทางการหมุนเปลี่ยนไป แต่ขาไมโครคอนโทรลเลอร์ไม่สามารถจ่ายกระแสให้มอเตอร์ ได้โดยตรง จึงต้องใช้วงจรขับกำลังเป็นตัวกลาง

วงจร H-bridge ใช้ชุดสวิตช์กำหนดทิศทางกระแสและขั้วแรงดันที่จ่ายให้มอเตอร์ จึงรองรับการหมุน ได้สองทิศทาง L298 เป็นวงจรขับแบบ dual full-bridge สำหรับโหลดเหนี่ยวนำ เช่น มอเตอร์ DC ในงานนี้ Arduino จะมีหน้าที่ส่งสัญญาณกำหนดทิศทางและ PWM ไปยัง L298N เพื่อควบคุมล้อซ้ายและขวาแยกกัน


รูปที่ 4 มอดูล L298N H-Bridge
(ที่มา: https://components101.com/modules/l293n-motor-driver-module)

### 2.2.3 Encoder และการวัดความเร็ว

Rotary encoder แปลงการหมุนของเพลาให้เป็นพัลส์ดิจิทัล เมื่อนับจำนวนพัลส์ต่อรอบและจำนวน พัลส์ในช่วงเวลาที่กำหนด จะสามารถประมาณระยะทางและความเร็วเชิงเส้นของล้อได้ หากล้อมีรัศมี R และ encoder มีความละเอียด N tick ต่อรอบ ระยะทางที่ล้อเคลื่อนที่ต่อหนึ่ง tick คำนวณได้จาก

Δs_(tick) =(2πR)/N

หากจำนวน tick เปลี่ยนไป Δn ในช่วงเวลา Δt ระยะทางและความเร็วเฉลี่ยของล้อประมาณได้จาก

Δs=ΔnΔs_(tick) ,≈(Δs)/(Δt)

ระบบนี้กำหนดรัศมีล้อ R=0.065m และความละเอียด N=1920 tick/rev จึงได้ ระยะทางเชิงทฤษฎีประมาณ 2.13×10^(-4) m/tick หรือประมาณ 0.213 mm ต่อ tick ค่านี้เป็น ความสัมพันธ์จากพารามิเตอร์ที่กำหนด ไม่ใช่ผลการวัดความแม่นยำของตัวรถ เนื่องจากค่าจริงยังขึ้นกับความ ละเอียด encoder การกำหนดขอบสัญญาณใน firmware และลักษณะการสัมผัสระหว่างล้อกับพื้น ซึ่งเป็นปัจจัยที่อาจทำให้เกิดความคลาดเคลื่อน

### 2.2.4 การควบคุมความเร็วแบบป้อนกลับ

ระบบควบคุมแบบป้อนกลับ (feedback control) นำค่าที่วัดได้มาเปรียบเทียบกับค่าเป้าหมาย แล้ว นำความคลาดเคลื่อนที่ได้ไปปรับคำสั่งควบคุม ตัวควบคุม PID ประกอบด้วยส่วนสัดส่วน (proportional: P) ส่วนอินทิกรัล (integral: I) และส่วนอนุพันธ์ (derivative: D) สมการในโดเมนเวลาต่อเนื่องเขียนโดยย่อได้ดังนี้

u(t)=K_p e(t)+K_i ∫_0^t e(τ)dτ+K_d (de(t))/(dt),e(t)=r(t)-y(t)

โดย r(t) คือค่าเป้าหมาย y(t) คือค่าที่วัดได้ และ u(t) คือคำสั่งควบคุม ส่วน P ตอบสนอง ต่อความคลาดเคลื่อนปัจจุบัน ส่วน I สะสมความคลาดเคลื่อนตามเวลา และส่วน D พิจารณาอัตราการเปลี่ยน แปลงของความคลาดเคลื่อน การนำ PID ไปใช้บนไมโครคอนโทรลเลอร์เป็นการคำนวณแบบไม่ต่อเนื่อง ณ เวลาสุ่มตัวอย่าง T_s จึงประมาณอินทิกรัลด้วยผลรวมของตัวอย่าง และประมาณอนุพันธ์ด้วยผลต่างระหว่าง ตัวอย่าง การจำกัดเอาต์พุตและผลรวมอินทิกรัลช่วยลดปัญหา integral windup เมื่อคำสั่งขับถึงขีดจำกัด

ในโครงงาน Arduino ใช้ตัวควบคุม PID แยกสำหรับล้อซ้ายและล้อขวา โดยอัปเดตวงควบคุม ประมาณทุก 20 ms หรือ 50 Hz ความเร็วที่คำนวณจาก tick จะผ่านตัวกรองเอ็กซ์โพเนนเชียลก่อนนำไป ป้อนกลับ ส่วนอนุพันธ์คำนวณจากการเปลี่ยนแปลงของความเร็วที่วัดได้ นอกจากนี้ firmware ยังเพิ่ม feed-forward ตามความเร็วเป้าหมายและจำกัดผลรวมอินทิกรัลไว้ในช่วงที่กำหนด วิธีนี้ใช้ทั้งการชดเชยจาก แบบจำลองอย่างง่ายและการแก้ความคลาดเคลื่อนจาก encoder โดยผลลัพธ์ยังขึ้นกับการปรับค่าให้เหมาะ กับมอเตอร์และโหลดจริง

เมื่อนำหลักการดังกล่าวมาเขียนในรูปแบบไม่ต่อเนื่อง ให้ T_s เป็นช่วงเวลาสุ่มตัวอย่าง v_(raw) [k] เป็นความเร็วที่คำนวณจาก tick และ v_f [k] เป็นความเร็วหลังการกรอง การคำนวณใน Arduino สรุปได้โดยประมาณดังนี้

v_f [k]=0.85v_f [k-1]+0.15v_(raw) [k],

e[k]=r[k]-v_f [k]

I[k]=clip(I[k-1]+e[k]T_s ,-2,2),

D_v [k]=(v_f [k]-v_f [k-1])/(T_s)

u[k]=(r[k])/(v_(cruise))u_(ff) +K_p e[k]+K_i I[k]-K_d D_v [k]

ในสมการนี้ ถูกจำกัดให้อยู่ในช่วง PWM ที่ฮาร์ดแวร์รองรับ และกำหนดค่า PWM ขั้นต่ำเมื่อมีคำสั่ง เคลื่อนที่ เพื่อไม่ให้ผลคำนวณที่มีค่าน้อยทำให้คำสั่งหายไป ค่า gain, feed-forward และขีดจำกัดต่าง ๆ เป็นค่าที่ตั้งไว้สำหรับ firmware ของโครงงาน จึงไม่ใช่ค่าทั่วไปที่รับรองสมรรถนะ กับมอเตอร์ทุกชนิด

เมื่อหุ่นยนต์เคลื่อนที่ตรง firmware เปรียบเทียบระยะสะสมของล้อทั้งสองเพื่อปรับ ตำแหน่งเป้าหมายแยกกันและลดการเบี่ยงเบนจากเส้นทางตรง ช่วงเริ่มต้นจะเพิ่มความเร็วเป้าหมายเป็นขั้น และลด ความเร็วเมื่อเข้าใกล้ระยะปลายทาง หากมีการวางตำแหน่งเป้าหมายแต่ encoder ไม่แสดงการเคลื่อนที่ ระบบจะเพิ่ม PWM อย่างจำกัด และรายงานสถานะ fault เมื่อไม่พบการเคลื่อนที่ต่อเนื่องเกินเวลาที่กำหนด กลไกเหล่านี้ เป็นวิธีควบคุมและจัดการความผิดปกติของ firmware


รูปที่ 5 แผนภาพ Feedback Loop ของระบบควบคุมมอเตอร์ภายในหุ่นยนต์

## 2.3 การเคลื่อนที่แบบ Differential Drive และ Odometry

หุ่นยนต์แบบ Differential Drive ขับเคลื่อนด้วยล้อสองข้างที่ควบคุมความเร็วแยกจากกัน โดยล้อทั้งสองมีแกนหมุนร่วมกันและล้อประคองช่วยพยุงตัวรถ ให้ v_L และ v_R เป็นความเร็วเชิงเส้น ของล้อซ้ายและขวา และให้ d เป็นระยะระหว่างศูนย์กลางล้อขับ ความเร็วเชิงเส้นของจุดกึ่งกลางรถ v และความเร็วเชิงมุมรอบแกนตั้ง ω เป็นดังนี้

v=(v_R +v_L)/2,

ω=(v_R -v_L)/d

เมื่อความเร็วของล้อทั้งสองเท่ากัน หุ่นยนต์จะเคลื่อนที่เป็นเส้นตรงโดยประมาณ ส่วนความเร็วที่ต่าง กันทำให้รถเคลื่อนที่เป็นแนวโค้ง หากล้อหมุนสวนทางกันด้วยความเร็วใกล้เคียงกัน รถจะหมุนรอบตัวเอง แบบจำลองนี้ใช้แปลงคำสั่งการเคลื่อนที่เป็นความเร็วของล้อ และใช้ประมาณการเปลี่ยนตำแหน่งจาก encoder อย่างไรก็ตาม แบบจำลองเชิงจลนศาสตร์ไม่ได้อธิบายแรง มวล หรือพลวัตของมอเตอร์โดยละเอียด

Odometry คือการประมาณตำแหน่งและทิศทางจากการเคลื่อนที่สะสมของล้อ ในช่วงเวลาหนึ่งให้ การเคลื่อนที่ของล้อซ้ายและขวาเป็น Δs_L และ Δs_R จะได้การเคลื่อนที่ของจุดกึ่งกลางและการเปลี่ยน heading ดังนี้

Δs=(Δs_R +Δs_L)/2,

Δθ=(Δs_R -Δs_L)/b

การอินทิเกรตตำแหน่งด้วยวิธี midpoint ประมาณได้จาก

x_(k+1) =x_k +Δscos(θ_k +Δθ/2),

y_(k+1) =y_k +Δssin(θ_k +Δθ/2),

θ_(k+1) =θ_k +Δθ

ในระบบนี้ Raspberry Pi ใช้ tick ซ้ายและขวาที่รับจาก Arduino เพื่อคำนวณ pose โดยกำหนดค่ารัศมีล้อ R=0.065m , ระยะห่างล้อ b=0.343m และความละเอียด N=1920 tick/rev เส้นทางภารกิจใช้ waypoint ที่กำหนดตำแหน่งสถานีทางแยกโต๊ะไว้ล่วงหน้า จากนั้นใช้ตำแหน่งและ heading จาก odometry เพื่อควบคุมช่วงทางและการเลี้ยว วิธีนี้มีโครงสร้างตรงไปตรงมา และเหมาะกับเส้นทางที่ทราบรูปแบบ แต่ไม่เทียบเท่ากับการรู้ตำแหน่งสัมบูรณ์ ของรถ

ในการออกแบบโจทย์สำหรับทดลอง จะกำหนดกรอบพิกัดของเส้นทางกำหนดสถานีเริ่มต้นเป็น (0,0) และทิศออกจากสถานีเป็นแกน +X ค่าเริ่มต้นใน configuration กำหนดทางแยกที่ (2.0,0) m และกำหนดตำแหน่งโต๊ะ 1 กับโต๊ะ 2 ที่ (2.0,+0.6) m และ (2.0,-0.6) m ตามลำดับตัวควบคุม waypoint ใช้เป้าหมายเหล่านี้เพื่อแยกการเดินทางเป็นช่วงตรงและช่วงปรับ heading โดยใช้ pose ปัจจุบัน จาก odometry เป็น feedback เส้นทางจึงเป็นเส้นทางที่ระบุไว้ล่วงหน้า ไม่ใช่การค้นหาเส้นทางอิสระจาก แผนที่ในทุกครั้งที่เดินทาง เพราะถือว่าในโจทย์การทดสอบเป็นร้านอาหารขนาดเล็ก ไม่จำเป็นต้องมีการคำนวณทิศทางซับซ้อน

เนื่องจาก odometry คำนวณตำแหน่งจากการเคลื่อนที่สะสม (dead reckoning) ความคลาดเคลื่อน จึงเพิ่มขึ้นตามระยะทาง ความคลาดเคลื่อนเชิงระบบอาจเกิดจากเส้นผ่านศูนย์กลางล้อซ้ายและขวาที่ไม่เท่ากัน หรือจากระยะห่างล้อจริงที่ต่างจากค่าที่ใช้คำนวณ ขณะที่การลื่นไถล การกระจายน้ำหนัก และพื้นผิวทำให้เกิด ความคลาดเคลื่อนที่เปลี่ยนแปลงตามสภาวะ จึงมีขั้นตอนการแก้ไง โดยอ้างอิงจากงานของ Borenstein และ Feng ซี่งวิเคราะห์วิธีวัดและแก้ความคลาดเคลื่อนเชิงระบบจากขนาดล้อและระยะห่างล้อ จึงสนับสนุนความ จำเป็นในการสอบ เทียบพารามิเตอร์กับตัวรถจริง


รูปที่ 6 ลักษณะการขับเคลื่อนด้วยวิธี Differential Drive โดยการสั่งให้ล้อไปทางเดียวกันคือการไปข้างหน้า หรือไปหลัง ส่วนการสั่งให้ล้อขับทิศตรงข้ามกันด้วยความเร็วเท่ากันจะทำให้หุ่นยนต์หมุนรอบตัวเอง
(ที่มา: https://existentialrobotics.org/RobotProvingGrounds/algorithms/control/content/diffy_drive/)


รูปที่ 7 การคำนวณตำแหน่งของหุ่นยนต์บนแผนที่โดยหลักการ Odometry โดยจะใช้ค่า รัศมีล้อ ระยะห่างระหว่างล้อ ระยะทางที่ล้อขยับแต่ละข้าง โดยได้ผลลัพธ์ออกมาคือตำแหน่ง และมุมของหุ่นยนต์
(ที่มา: https://hackaday.io/project/158496-imcoders/log/147068-robot-odometry)

## 2.4 เซนเซอร์และการตรวจจับสิ่งกีดขวาง

### 2.4.1 Keypad 4×4 และตัวขยายพอร์ต PCF8574

Keypad แบบเมทริกซ์จัดปุ่มเป็นแถวและคอลัมน์ ทำให้ไมโครคอนโทรลเลอร์อ่านปุ่มหลายปุ่มได้โดย ใช้สายสัญญาณน้อยกว่าการต่อปุ่มแต่ละปุ่มแยกกัน PCF8574 เป็นตัวขยายพอร์ตดิจิทัล 8 บิตที่สื่อสารผ่าน บัส I2C ซึ่งใช้สายข้อมูล SDA และสายนาฬิกา SCL การต่อ keypad ผ่านตัวขยายพอร์ตช่วยลดจำนวนขา GPIO ที่ต้องใช้และสงวนขาอื่นไว้สำหรับ encoder และมอเตอร์

ในโครงงาน PCF8574 เชื่อมต่อสาย SDA และ SCL กับขา A4 และ A5 ของ Arduino Uno ตามลำดับ โดยใช้ address เริ่มต้น 0x20 กำหนดขา P7–P4 เป็นแถวและ P3–P0 เป็นคอลัมน์ เมื่อมีการกด ปุ่ม Arduino จะส่งข้อความเหตุการณ์ที่ขึ้นต้นด้วย KEY: พร้อมอักขระของปุ่มไปยัง Raspberry Pi จากนั้น POS จะตีความคำสั่งตามสถานะภารกิจ


รูปที่ 8 Keypad แบบเมทริกซ์ขนาด 4x4
(ที่มา: https://electropeak.com/flat-keypad-4x4)


รูปที่ 9 PCF8574 สำหรับการเชื่อมต่อ Keypad
(ที่มา: https://www.letscontrolit.com/wiki/index.php/PCF8574)

### 2.4.2 LiDAR และเขตหยุดเพื่อความปลอดภัย

LiDAR แบบระนาบวัดระยะถึงวัตถุจากหลายมุมและส่งผลเป็นข้อมูลเชิงขั้ว ข้อความ LaserScan ของ ROS 2 ระบุขอบเขตมุม ช่วงเพิ่มของมุมต่อหนึ่งตัวอย่าง ช่วงระยะที่ใช้งานได้ และค่าระยะของลำแสงแต่ละ ตัวอย่างข้อมูลนี้อาจใช้แสดงสภาพแวดล้อม สร้างแผนที่ หรือตรวจเขตด้านหน้าเพื่อสั่งหยุด การเลือกใช้งานขึ้น กับวัตถุประสงค์และอัลกอริทึมของระบบ การติดตั้ง LiDAR เพียงอย่างเดียวจึงไม่ได้ทำให้หุ่นยนต์นำทางหรือ หลบสิ่งกีดขวางได้ครบถ้วน

หากให้ระยะของลำแสงตัวที่ i เป็น r_i และมุมเป็น ϕ_i =angle_(min) + i angle_(max) จุดวัดในระนาบสามารถเขียนในพิกัดคาร์ทีเซียนได้เป็น x_i =r_i cosϕ_i และ y_i =r_i sinϕ_i การแปลง นี้ช่วยเชื่อมข้อมูลมุมกับตำแหน่งที่ตรวจพบเมื่อพิจารณาเทียบกับกรอบพิกัดของเซนเซอร์และตัวรถ

ซอฟต์แวร์ตรวจจับจาก LiDAR พิจารณาเฉพาะพื้นที่รูปกรวยด้านหน้าหุ่นยนต์ โดยคัดค่าที่ไม่ใช่ตัวเลข ค่าที่ไม่เป็นจำนวนจำกัด หรือค่าระยะที่อยู่นอกช่วงที่กำหนด แล้วนับจำนวนจุดภายในเขตหยุด ค่าเริ่มต้นคือ มุมครึ่งกรวย 35 องศา ระยะหยุด 0.30 m ระยะใกล้สุดที่พิจารณา 0.22 m และกำหนดให้พบอย่างน้อยสาม จุดก่อนรายงานสิ่งกีดขวาง ค่าระยะหยุดปรับได้ผ่านตัวแปรสภาพแวดล้อม เมื่อพบสิ่งกีดขวาง ตัวควบคุม waypoint จะหยุดคำสั่งเดินหน้าและรอจนพื้นที่กลับมาโล่ง โดยระบบต้องได้รับข้อมูล LiDAR ผ่าน ROS 2 ในหัวข้อ /scan

วิธีการกำหนดจำนวนจุดขั้นต่ำช่วยลดการตอบสนองต่อค่าผิดปกติจากลำแสงเพียงจุดเดียว อย่างไรก็ ตามระบบนับจำนวนจุดทั้งหมดที่ผ่านเงื่อนไขในกรวย โดยไม่ได้จัดกลุ่มจุดหรือกำหนดว่าจุดต้อง ต่อเนื่องกัน ตามมุม จึงใช้จำนวนจุดนี้ระบุรูปทรงหรือแยกวัตถุไม่ได้ นอกจากนี้ระยะหยุดเป็นค่าเกณฑ์คงที่ ไม่ได้คำนวณ จากความเร็วปัจจุบัน ระยะเบรก หรือความหน่วงในการสื่อสาร

ดังนั้น กลไกนี้ทำหน้าที่เป็น virtual bumper ที่สั่งหยุดเมื่อข้อมูล LiDAR ผ่านเกณฑ์ที่กำหนด ขอบเขตการทำงานไม่ครอบคลุมการจำแนกวัตถุ การวางแผนเส้นทางหลบหลีก หรือการรับรองระยะหยุด ภายใต้ทุกสภาวะ การประเมินในสภาพใช้งานจริงยังต้องพิจารณาตำแหน่งติดตั้ง ชนิดพื้นผิว รูปร่างของวัตถุ และความเร็วของหุ่นยนต์


รูปที่ 10 RPLiDAR A1 สำหรับการตรวจจับวัตถุ
(ที่มา: https://core-electronics.com.au/slamtec-rplidar-a1-360-laser-range-scanner.html)

## 2.5 การสื่อสารและการจัดการสถานะ

### 2.5.1 Serial communication และ ROS 2

การสื่อสารแบบอนุกรม (serial communication) ส่งข้อมูลเป็นลำดับระหว่างอุปกรณ์ ผู้ส่งและผู้รับ ต้องใช้อัตราบิตและรูปแบบกรอบข้อมูลที่สอดคล้องกัน Arduino กำหนดอัตราบิตด้วยคำสั่ง Serial.begin() ในโครงงาน Arduino เชื่อมต่อกับ Raspberry Pi ผ่าน USB Serial ที่ 115200 baud และใช้การขึ้นบรรทัด ใหม่เป็นตัวแบ่งข้อความ วิธีนี้ช่วยให้โปรแกรมปลายทางรับข้อมูลทีละบรรทัดและจำแนกประเภทจากคำ นำหน้าได้

ข้อความจาก Arduino ประกอบด้วยข้อมูล encoder ในรูปแบบ ENCODER:<left>,<right> ข้อความสถานะ STATUS:<สถานะ> และเหตุการณ์จาก keypad KEY:<char> ส่วน Raspberry Pi ส่ง คำสั่งเดินหน้า เลี้ยว หยุด กำหนดความเร็วต่อเนื่อง และควบคุมไฟเลี้ยว เมื่อเลือกใช้ ROS 2 ตัวเชื่อมต่อ ซอฟต์แวร์จะแลกเปลี่ยนข้อมูล Serial กับ topic เช่น /cmd_vel, /odom และ /keypad/key ส่วนการ เชื่อมต่อแบบ Serial โดยตรงให้ซอฟต์แวร์หลักอ่านพอร์ตของ Arduino โดยตรง ทั้งสองรูปแบบเป็นทาง เลือกของช่องทางสื่อสารในระดับซอฟต์แวร์และใช้ฮาร์ดแวร์ควบคุมชุดเดียวกัน

คำนำหน้าและตัวคั่นช่วยให้โปรแกรมแยกประเภทข้อความก่อนแปลงข้อมูล โปรแกรมจะละเว้น บรรทัดที่ไม่ตรงรูปแบบหรือแปลงเป็นตัวเลขไม่ได้ ส่วนตัวเชื่อมต่อ ROS 2 จะตรวจสอบความใหม่ของข้อมูล encoder ก่อนรายงานสถานะพร้อมรับคำสั่ง วิธีเหล่านี้ช่วยตรวจข้อผิดพลาดด้านรูปแบบและการขาด ข้อมูลบางกรณี แต่ยังต้องใช้อัตราบิตตรงกันและจัดการข้อมูลที่อ่านมาไม่ครบตามพฤติกรรมของพอร์ตสื่อสาร

หน้าจอ POS/Kiosk ติดต่อกับเซิร์ฟเวอร์ POS ผ่าน HTTP ส่วน keypad ส่งเหตุการณ์เข้าสู่ เซิร์ฟเวอร์เดียวกัน การใช้ข้อมูลร่าง (draft) ชุดเดียวกันทำให้การป้อนข้อมูลจากหน้าจอและ keypad ปรับปรุงรายการภารกิจเดียวกันได้ อย่างไรก็ตามช่องทางที่พร้อมใช้งานขึ้นกับการตั้งค่า backend และ ซอฟต์แวร์ที่เริ่มทำงานในแต่ ละครั้ง


รูปที่ 11 แสดงโครงสร้างการส่ง Data ระดับ Bit ของการสื่อสารแบบ Serial Communication UART
(ที่มา: https://developer.electricimp.com/resources/uart)


รูปที่ 12 แผนภาพการทำงานของ ROS Action: Client ส่งเป้าหมายให้ Server, รับความคืบหน้าผ่าน Topic และรับผลลัพธ์เมื่อทำงานเสร็จ
(ที่มา: https://docs.ros.org/en/dashing/Tutorials/Understanding-ROS2-Actions.html)

### 2.5.2 Finite State Machine และการทำงานตามเวลา

Finite State Machine (FSM) เป็นแบบจำลองพฤติกรรมที่ประกอบด้วยสถานะและเงื่อนไขการ เปลี่ยนสถานะ แบบจำลองนี้เหมาะกับงานที่มีลำดับและเงื่อนไขชัดเจน เพราะช่วยระบุว่าแต่ละเหตุการณ์ เกิดขึ้นได้ในสถานะใด และเมื่อเกิดข้อผิดพลาดระบบควรเข้าสู่สถานะใด โครงงานใช้ FSM ระดับภารกิจเพื่อ จัดการการรับรายการ เริ่มเดินทาง รอผู้ใช้ยืนยันการรับอาหาร ตรวจสอบรายการที่เหลือ เดินทางกลับ และจัดการข้อผิดพลาด ส่วน firmware แยกสถานะคำสั่งเคลื่อนที่ เช่น idle, forward, turn และ velocity ออกจากสถานะของภารกิจ การแบ่งระดับนี้ช่วยให้ตรรกะการให้บริการไม่ปะปนกับการควบคุมมอเตอร์

ในเชิงแบบจำลอง FSM ระดับภารกิจอธิบายได้ด้วยชุดสถานะ S เหตุการณ์นำเข้า E ฟังก์ชัน เปลี่ยนสถานะ δ และสถานะเริ่มต้น การเปลี่ยนสถานะจะเกิดขึ้นเมื่อระบบได้รับเหตุการณ์ที่เหมาะสมกับ สถานะปัจจุบัน เช่น รับภารกิจใหม่เมื่อรอคำสั่ง หรือยืนยันรับอาหารเมื่อถึงช่วงรอรับอาหาร หากการนำทาง ไม่สำเร็จหรือข้อมูลภารกิจไม่สมบูรณ์ ระบบเปลี่ยนไปสู่สถานะข้อผิดพลาด และสั่งหยุดการ เคลื่อนที่การ จัดรูปแบบเช่นนี้ทำให้เงื่อนไขปกติและเงื่อนไขผิดพลาดสามารถตรวจสอบแยกกันได้ ทั้งยังช่วยให้การทดสอบ ภารกิจจำลองลำดับเหตุการณ์ของผู้ใช้ได้โดยไม่ต้องพึ่งวงจรมอเตอร์ทุกกรณี

อีกทั้งระบบใช้ watchdog, timeout และสถานะ fault เพื่อจัดการเมื่อข้อมูลหรือการเคลื่อนที่ ขาดหาย ตัวอย่างเช่น ระบบหยุดคำสั่งความเร็วต่อเนื่องเมื่อไม่ได้รับคำสั่งใหม่ภายในช่วงเวลาที่กำหนด และเมื่อ encoder ไม่แสดงความคืบหน้า ระบบจะเพิ่มแรงขับอย่างจำกัดหรือหยุดพร้อมรายงานสถานะ ผิดพลาด

## 2.6 ระบบจ่ายไฟและวงจรขับกำลัง

แหล่งจ่ายหลักของหุ่นยนต์คือแบตเตอรี่ลิเธียม 12 V 15 Ah พร้อมสวิตช์และบัสบาร์สำหรับกระจาย ไฟวงจร L298N ขับมอเตอร์ ส่วนตัวแปลงไฟ DC–DC แบบ buck และตัวแปลง DC–DC อีกชุดที่ติดตั้งใน ระบบทำหน้าที่ปรับแรงดันให้เหมาะกับอุปกรณ์อิเล็กทรอนิกส์ เนื่องจากกระแสที่มอเตอร์ใช้เปลี่ยนตามภาระ การออกแบบแหล่งจ่ายจึงต้องคำนึงถึงผลของโหลดมอเตอร์ต่อแรงดันของระบบ

การประเมินภาระทางไฟฟ้าเบื้องต้นพิจารณากำลังจากความสัมพันธ์ P=VI และพลังงานจากผล คูณของกำลังกับเวลา สำหรับแบตเตอรี่ที่ระบุ 12 V และ 15 Ah จึงคำนวณความจุพลังงานได้เป็น 180 Wh โดยประมาณภายใต้เงื่อนไขพิกัด อย่างไรก็ดี ค่านี้ไม่ใช่พลังงานที่ใช้ได้จริงทั้งหมดและไม่เพียงพอที่จะระบุระยะ เวลาทำงาน เพราะขึ้นกับประสิทธิภาพตัวแปลง กระแสของมอเตอร์และคอมพิวเตอร์ ภาระหน้าจอและ เงื่อนไขการคายประจุ


รูปที่ 13 แบตเตอรี่ลิเทียม 12V 15A ที่ใช้ในโครงงานนี้
(หมายเหตุ: ภาพถ่ายโดยผู้จัดทำ)

## 2.7 สรุป

บทนี้อธิบายสถาปัตยกรรมระบบฝังตัวและการแบ่งหน้าที่ระหว่าง Arduino กับ Raspberry Pi หลักการรับสัญญาณ encoder การควบคุมมอเตอร์แบบป้อนกลับ และแบบจำลอง Differential Drive สำหรับคำนวณ odometry นอกจากนี้ยังกล่าวถึงข้อจำกัดของการประมาณตำแหน่งแบบ dead reckoning การรับข้อมูลจาก keypad และ LiDAR การสื่อสารผ่าน Serial/ROS 2 และการจัดลำดับภารกิจด้วย FSM เนื้อหาเหล่านี้เชื่อมโยงเส้นทางข้อมูลจากผู้ใช้และเซนเซอร์ไปสู่คำสั่งควบคุมการเคลื่อนที่ หุ่นยนต์เดินทางตาม waypoint ที่กำหนดไว้ ใช้ encoder odometry เพื่อประมาณตำแหน่ง และใช้ LiDAR guard สั่งหยุดเมื่อพบ วัตถุในเขตด้านหน้าตามเงื่อนไขที่ตั้งไว้ ผู้ใช้ยืนยันการรับอาหารผ่าน POS/Kiosk หรือ keypad

# บทที่ 3 วิธีการดำเนินการ

## 3.1 การทำงานโดยภาพรวม

ระบบหุ่นยนต์ส่งอาหารต้นแบบแบ่งการทำงานเป็นสองส่วนหลัก ได้แก่ Raspberry Pi 4 ซึ่งประมวล ผลภารกิจและจัดการส่วนติดต่อผู้ใช้ และ Arduino Uno R3 ซึ่งควบคุมอุปกรณ์ระดับฮาร์ดแวร์ จอสัมผัส แสดงระบบ POS สำหรับกำหนดชั้นวางและโต๊ะปลายทาง รวมถึงยืนยันการวางและการรับอาหาร ผู้ใช้ สามารถใช้ Keypad 4×4 เป็นช่องทางป้อนคำสั่งแทนการสัมผัสได้เช่นกัน โดยทั้งสองช่องทางอ้างอิงรายการ ภารกิจชุดเดียวกัน

เมื่อผู้ใช้ยืนยันรายการ ระบบ POS ส่งภารกิจให้โปรแกรมควบคุมบน Raspberry Pi จัดลำดับการ ทำงานตาม Finite State Machine (FSM) และกำหนดจุดนำทาง (Waypoint) สำหรับโต๊ะที่เลือก Raspberry Pi ส่งคำสั่งความเร็วผ่าน ROS 2 และ USB Serial ไปยัง Arduino Uno เพื่อขับมอเตอร์ผ่านวงจร L298N ขณะเดียวกัน Arduino อ่านค่า Encoder ของล้อทั้งสองข้างและส่งค่ากลับเพื่อคำนวณการเคลื่อนที่
ของหุ่นยนต์

LiDAR ใช้ตรวจสอบสิ่งกีดขวางระหว่างเดินทาง หากพบวัตถุอยู่ในระยะที่กำหนด ระบบจะหยุดการ
เคลื่อนที่ชั่วคราวและเดินทางต่อเมื่อเส้นทางปลอดภัย ส่วน SLAM ใช้สร้างและแสดงแผนที่สภาพแวดล้อม
ในการพัฒนาและตรวจสอบระบบ โดยการเดินทางตามภารกิจในรุ่นนี้ยังอาศัย Waypoint ที่กำหนดไว้ ปัจจุบันยังไม่ได้ให้ SLAM วางเส้นทางอัตโนมัติ เพราะข้อจำกัดด้านพื้นที่ที่ใช้ทดสอบ Arduino Uno ควบคุมจอ MAX7219 Dot Matrix ให้แสดง ลูกศรตามทิศทางการเลี้ยว เมื่อถึงโต๊ะผู้ใช้ยืนยันการรับอาหาร ผ่านจอ POS หรือ Keypad จากนั้นหุ่นยนต์จึงไป โต๊ะถัดไปหรือกลับจุดเริ่มต้น

### 3.1.1 ลำดับสถานะการส่งอาหาร

โปรแกรมควบคุมหลักเริ่มจากสถานะ WAIT_FOR_POS เพื่อรอภารกิจจาก POS เมื่อได้รับรายการ ระบบหยุดรถและแสดง PREPARING บนหน้าจอเป็นเวลา 5 วินาที จากนั้นตรวจความพร้อมของระบบนำทาง ก่อนเข้าสู่ DELIVERING เพื่อเดินทางไปยังโต๊ะปลายทาง เมื่อถึงโต๊ะจะเข้าสู่ WAIT_PICKUP และรอให้ผู้ใช้ ยืนยันการรับอาหารผ่านจอ POS หรือ Keypad หลังยืนยัน ระบบแสดง PICKUP_DELAY และหยุดอีก 5 วินาที ก่อนเข้าสู่ CHECK_REMAIN เพื่อตรวจรายการที่เหลือ หากมีโต๊ะถัดไปจะกลับไป DELIVERING แต่หากส่งครบ แล้วจะเข้าสู่ RETURN_STATION เพื่อเดินทางกลับจุดเริ่มต้น เมื่อกลับถึงระบบแสดง COMPLETED และกลับสู่ WAIT_FOR_POS หากระบบนำทางทำงานไม่สำเร็จ โปรแกรมจะเข้าสู่ ERROR และรอคำสั่งรีเซ็ต ดังรูปที่ 14

FSM หลัก 6 สถานะตามโค้ด DeliveryFSM

รูปที่ 14 แผนภาพ FSM หลักของระบบหุ่นยนต์ส่งอาหาร

การยกเลิกภารกิจทำได้ระหว่างการเตรียมเดินทาง การเคลื่อนที่ และการรอยืนยันรับอาหารโดยโปรแกรมจะ สั่งหยุดรถ ล้างข้อมูลภารกิจ และกลับสู่ WAIT_FOR_POS ส่วนการตรวจสิ่งกีดขวางด้วย LiDAR เป็นเงื่อนไข หยุดชั่วคราวระหว่างการเดินหน้าของ DELIVERING และ RETURN_STATION ไม่ใช่สถานะใหม่ของ FSM หลัก เมื่อทางโล่ง หุ่นยนต์จึงเดินทางต่อในเส้นทางเดิม

## 3.2 การทำงานของฮาร์ดแวร์

### 3.2.1 ผังการเชื่อมต่อและระบบจ่ายไฟ

รูปที่ 15 แสดงองค์ประกอบของระบบต้นแบบ ได้แก่ แบตเตอรี่และชุดจ่ายไฟ Raspberry Pi 4 จอสัมผัส LiDAR Arduino Uno วงจรขับมอเตอร์ มอเตอร์พร้อม Encoder Keypad ผ่าน PCF8574 และจอ Dot Matrix โดย Raspberry Pi เชื่อมต่อ Arduino และ LiDAR ผ่าน USB จอสัมผัสรับสัญญาณภาพผ่าน HDMI และข้อมูลสัมผัสผ่าน USB


รูปที่ 15 ผังการเชื่อมต่ออุปกรณ์โดยรวมของหุ่นยนต์

แบตเตอรี่ 12 V จ่ายพลังงานให้ส่วนขับเคลื่อน และส่งผ่านวงจรลดแรงดันสำหรับส่วนควบคุมและ อุปกรณ์แสดงผล สายกราวด์ของวงจรที่สื่อสารหรือควบคุมร่วมกันต้องอ้างอิงจุดกราวด์เดียวกัน และต้อง ตรวจสอบแรงดัน จริงที่ขั้วอุปกรณ์ก่อนเปิดระบบ โดยเฉพาะ Raspberry Pi และจอ Dot Matrix ที่ต้อง ใช้แรงดัน 5 V ที่เหมาะสม

รูปที่ 16 ส่วนแหล่งจ่ายไฟและการกระจายแรงดัน

### 3.2.2 Raspberry Pi จอสัมผัส และ LiDAR

Raspberry Pi 4 ทำหน้าที่รัน POS โปรแกรมควบคุมภารกิจ ROS 2 และส่วนรับข้อมูล LiDAR จอสัมผัสขนาด 7 นิ้วใช้แสดงรายการอาหาร สถานะภารกิจ และปุ่มยืนยันการรับอาหาร การเชื่อมต่อจอใช้สาย Micro HDMI สำหรับภาพและ USB สำหรับสัญญาณสัมผัส ส่วน RPLIDAR A1M8 เชื่อมต่อกับ Raspberry Pi ผ่านอะแดปเตอร์ USB ดังแสดงในรูปที่ 17

รูปที่ 17 การเชื่อมต่อ Raspberry Pi จอสัมผัส และ LiDAR

### 3.2.3 Arduino Uno ระบบขับเคลื่อน และ Encoder

Arduino Uno รับคำสั่งจาก Raspberry Pi ทาง USB Serial ที่อัตรา 115,200 บิตต่อวินาที และส่งสัญญาณควบคุมไปยัง L298N เพื่อขับมอเตอร์สองข้างแบบ Differential Drive สัญญาณจาก Encoder ของมอเตอร์ซ้ายและขวาเข้าสู่ขาอนาล็อกซึ่งกำหนดให้ทำหน้าที่เป็นอินพุตดิจิทัล Arduino ใช้ข้อมูลดังกล่าว ในการควบคุมความเร็วและส่งค่ากลับให้ Raspberry Pi สำหรับคำนวณระยะทางและ ทิศทางการเคลื่อนที่


รูปที่ 18 การเชื่อมต่อ Arduino Uno วงจรขับมอเตอร์ และ Encoder

### 3.2.4 Keypad และจอ MAX7219 Dot Matrix

Keypad 4×4 เชื่อมต่อผ่านโมดูลขยายขา PCF8574 ซึ่งสื่อสารกับ Arduino Uno ด้วย I2C โดยใช้ A4 เป็น SDA และ A5 เป็น SCL ค่าที่อยู่เริ่มต้นของโมดูลในโปรแกรมคือ 0x20 การกดปุ่มถูกแปลงเป็น ข้อความ KEY:<ปุ่ม> ส่งให้ Raspberry Pi เพื่อใช้ควบคุม POS สำหรับเลือกชั้นวาง โต๊ะปลายทาง และยืนยัน รับอาหาร

จอ MAX7219 Dot Matrix ขนาด 32×8 จุดประกอบด้วย 4 โมดูล รับสัญญาณ DIN, CS และ CLK จาก Arduino Uno เพื่อแสดงลูกศรเลี้ยวซ้ายหรือขวาตามคำสั่งของระบบ โดยจอนี้เป็นไฟแสดงทิศทาง ไม่ใช่ จอแสดงรายการอาหาร


รูปที่ 19 การเชื่อมต่อ Keypad, PCF8574 และจอ MAX7219

### 3.2.5 การกำหนดขาใช้งานของ Arduino Uno

รูปที่ 20 จัดวางภาพ Arduino Uno ไว้กลางตาราง โดยแสดงชื่อขาและหน้าที่สองด้านตาม รูปแบบผัง GPIO สีพื้นใช้แยกกลุ่มการใช้งาน ได้แก่ จอ Dot Matrix, มอเตอร์, Encoder, I2C และระบบ จ่ายไฟ รายการขาอ้างอิงโปรแกรมควบคุมรุ่นปัจจุบัน


| | | AREF | ไม่ได้ใช้งานในระบบ
| | | GND | กราวด์ร่วม
ไม่ได้ใช้งานในระบบ | IOREF | | D13 | ไม่ได้ใช้งานในระบบ
ไม่ได้ใช้งานในระบบ | RESET | | D12 | L298N IN3 มอเตอร์ขวา
ไม่ได้ใช้งานในระบบ | 3V3 | | D11 | L298N ENB มอเตอร์ขวา
ไฟเลี้ยงวงจรลอจิก | 5V | | D10 | L298N ENA มอเตอร์ซ้าย
กราวด์ร่วม | GND | | D9 | L298N IN2 มอเตอร์ซ้าย
กราวด์ร่วม | GND | | D8 | L298N IN1 มอเตอร์ซ้าย
ไม่ได้ใช้งานในระบบ | VIN | | D7 | L298N IN4 มอเตอร์ขวา
Encoder ขวา ช่อง B | A0 | | D6 | MAX7219 CLK
Encoder ขวา ช่อง A | A1 | | D5 | MAX7219 CS/LOAD
Encoder ซ้าย ช่อง B | A2 | | D4 | MAX7219 DIN
Encoder ซ้าย ช่อง A | A3 | | D3 | ไม่ได้ใช้งานในระบบ
I2C SDA - PCF8574 | A4 | | D2 | ไม่ได้ใช้งานในระบบ
I2C SCL - PCF8574 | A5 | | D1 | TX ผ่าน USB Serial
| | | D0 | RX ผ่าน USB Serial
| | USB Type-B เชื่อม Raspberry Pi 4

Raspberry Pi 4 ← USB Serial → Arduino Uno R3

รูปที่ 20 การกำหนดขา GPIO ของ Arduino Uno กับอุปกรณ์ในระบบ

ภายใน PCF8574 กำหนด P7–P4 เป็นสายแถว และ P3–P0 เป็นสายคอลัมน์ของ Keypad ส่วนขา D0/D1 เป็นขาสื่อสาร Serial ของบอร์ด จึงไม่ควรต่ออุปกรณ์อื่นร่วมระหว่างใช้งาน USB Serial ขาไฟเลี้ยงให้ต่อ
เฉพาะแรงดันที่ตรวจสอบตามผังจริงแล้ว

### 3.2.6 อุปกรณ์หลักที่ใช้ในระบบ

อุปกรณ์แต่ละชิ้นถูกเลือกตามหน้าที่ในระบบ โดย Raspberry Pi รับงานประมวลผลและส่วนติดต่อ ผู้ใช้ ส่วน Arduino รับงานที่ต้องตอบสนองกับสัญญาณมอเตอร์และ Encoder โดยตรง รายการสำคัญสรุปใน ตารางที่ 3.1

อุปกรณ์ | จำนวน | หน้าที่ในระบบ
Raspberry Pi 4 Model B | 1 | รัน POS, FSM, ROS 2 และโปรแกรมนำทาง
Arduino Uno R3 | 1 | ควบคุมมอเตอร์ อ่าน Encoder และ Keypad
RPLIDAR A1M8 | 1 | ตรวจระยะสิ่งกีดขวางและรับข้อมูลสแกน
จอสัมผัส 7 นิ้ว | 1 | แสดง POS และรับคำสั่งจากผู้ใช้
L298N Motor Driver | 1 | ขับมอเตอร์ซ้ายและขวา
มอเตอร์ DC พร้อม Encoder | 2 | ขับเคลื่อนและวัดการหมุนของล้อ
MAX7219 Dot Matrix 32×8 | 1 ชุด | แสดงลูกศรทิศทางการเลี้ยว
Keypad 4×4 และ PCF8574 | 1 ชุด | ป้อนข้อมูลไปยัง POS ผ่าน I2C
แบตเตอรี่ 12 V และวงจรลดแรงดัน | 1 ชุด | จ่ายไฟให้ส่วนขับเคลื่อนและส่วนควบคุม

ตารางที่ 3.1 อุปกรณ์หลักและหน้าที่ของแต่ละส่วน

## 3.3 การพัฒนาโปรแกรมและหลักการทำงาน

Arduino Uno ซึ่งรับผิดชอบการเคลื่อนที่และอุปกรณ์รอบตัว แล้วจึงอธิบาย Raspberry Pi รับผิดชอบรายการส่งอาหารและการตัดสินใจระดับระบบ ตัวอย่างโค้ดเป็นการคัดเฉพาะช่วงที่เห็นหลักการ ชัดเจนจากไฟล์ปัจจุบัน ไม่ใช่โปรแกรมเต็มทั้งไฟล์

Source Code ฉบับเต็ม: https://github.com/AungpaoK/EmbeddedProj

### 3.3.1 โปรแกรมควบคุมบน Arduino Uno

3.3.1.1 การควบคุมมอเตอร์ผ่าน L298N

รถใช้มอเตอร์สองตัวขับล้อซ้ายและขวาแยกจากกัน Arduino จึงต้องกำหนดทั้งทิศทางและกำลัง ขับของมอเตอร์แต่ละข้าง ฟังก์ชัน driveMotors รับค่า PWM แบบมีเครื่องหมาย หากค่าเป็นบวกให้หมุน ไปข้างหน้า หากเป็นลบให้กลับทิศ และหากเป็นศูนย์ให้หยุดมอเตอร์ ดูได้ดังโค้ดที่ 3.1 แสดงการแปลงคำสั่ง ดังกล่าวเป็นสัญญาณ สำหรับ L298N

void driveMotors(int leftPWM, int rightPWM) {
int pwmL = constrain(abs(leftPWM), 0, 255);
if (leftPWM > 0) { digitalWrite(IN1, HIGH); digitalWrite(IN2, LOW); }
else if (leftPWM < 0) { digitalWrite(IN1, LOW); digitalWrite(IN2, HIGH); }
else { digitalWrite(IN1, LOW); digitalWrite(IN2, LOW); }
analogWrite(ENA, pwmL);

int pwmR = constrain(abs(rightPWM), 0, 255);
if (rightPWM > 0) { digitalWrite(IN3, LOW); digitalWrite(IN4, HIGH); }
else if (rightPWM < 0) { digitalWrite(IN3, HIGH); digitalWrite(IN4, LOW); }
else { digitalWrite(IN3, LOW); digitalWrite(IN4, LOW); }
analogWrite(ENB, pwmR);
}

โค้ดที่ 3.1 ฟังก์ชันควบคุมทิศทางและ PWM ของมอเตอร์

คำสั่ง digitalWrite ใช้กำหนดทิศทางผ่านขา IN1–IN4 ส่วน analogWrite ใช้ส่ง PWM ไปยัง ENA และ ENB โดยจำกัดค่าอยู่ระหว่าง 0–255 การขับมอเตอร์แยกซ้ายและขวาทำให้รถเดินหน้า เลี้ยวหรือหมุนอยู่ กับที่ได้

3.3.1.2 การอ่าน Encoder และส่งค่าการหมุนของล้อ

Encoder ของแต่ละล้อส่งสัญญาณสองเฟสให้ Arduino โปรแกรมอ่านการเปลี่ยนขอบสัญญาณ เพื่อเพิ่มหรือลดตัวนับตามทิศทางหมุน และใช้ตัวนับนี้เป็นข้อมูลป้อนกลับสำหรับควบคุมความเร็ว ทุก 100
มิลลิวินาที Arduino ส่งจำนวน tick ของล้อซ้ายและขวาให้ Raspberry Pi ในรูปแบบ ENCODER:<ซ้าย>,<ขวา> ดังโค้ดที่ 3.2

// --- Encoder Broadcast (100 ms) ---
if (now - lastEncoderPrint >= ENCODER_PRINT_MS) {
lastEncoderPrint = now;
long L, R;
readTicks(L, R);
Serial.print("ENCODER:");
Serial.print(L);
Serial.print(",");
Serial.println(R);

โค้ดที่ 3.2 การส่งค่า Encoder ผ่าน Serial

การส่งจำนวน tick แทนระยะทางโดยตรงทำให้ Raspberry Pi นำข้อมูลไปคำนวณ odometry ด้วยค่ารัศมีล้อและระยะห่างล้อที่กำหนดไว้ในโปรแกรมได้ ขณะอ่านตัวนับ Arduino ใช้วิธีคัดลอกค่าโดยปิด interrupt ชั่วคราว เพื่อไม่ให้ค่าซ้ายและขวาเปลี่ยนระหว่างอ่าน

3.3.1.3 การอ่าน Keypad ผ่าน PCF8574

Keypad 4×4 ใช้ PCF8574 เป็นตัวขยายขาอินพุต–เอาต์พุตและต่อกับ A4/A5 ผ่าน I2C ทำให้ไม่ ต้องใช้ขา Arduino ถึง 8 ขาในการอ่านแถวและคอลัมน์ เมื่อพบการกดปุ่ม โปรแกรมจะส่งอักขระไปยัง Raspberry Pi โดยเติมคำนำหน้า KEY: เพื่อแยกจากข้อมูล Encoder และข้อความสถานะ

inline void updateAndSendToPi(Stream &serialPort) {
static unsigned long lastScanMs = 0;
const unsigned long nowMs = millis();
if (nowMs - lastScanMs < 10) {
return;
}
lastScanMs = nowMs;

char key = readKey();

if (key != NO_KEY) {
serialPort.print(F("KEY:"));
serialPort.println(key);
}

โค้ดที่ 3.3 การอ่าน Keypad และส่งข้อมูล KEY

การสแกนทุก 10 มิลลิวินาทีช่วยให้ตอบสนองต่อผู้ใช้โดยไม่ใช้ delay ค้างใน loop หลัก เช่น เมื่อกด A Arduino จะส่ง KEY:A พร้อมขึ้นบรรทัดใหม่ แล้วโปรแกรมบน Raspberry Pi จึงนำปุ่มนั้นไปตีความตาม สถานะของ POS

3.3.1.4 การแสดงลูกศรบน MAX7219

จอ Dot Matrix ใช้ชิป MAX7219 จำนวนสี่โมดูลต่อเรียงเป็นพื้นที่แสดงผล 32×8 จุด โค้ดที่ 3.4 แสดงการสร้างออบเจ็กต์ MD_MAX72XX โดยเลือกชนิดฮาร์ดแวร์ FC16_HW และส่งหมายเลขขา DIN, CLK และ CS จากไฟล์กำหนดค่าไปให้ไลบรารี

MD_MAX72XX matrix(
MD_MAX72XX::FC16_HW,
LED_MATRIX_DIN_PIN,
LED_MATRIX_CLK_PIN,
LED_MATRIX_CS_PIN,
MAX7219_COUNT
);

โค้ดที่ 3.4 การตั้งค่าจอ MAX7219

เมื่อ Raspberry Pi ส่งคำสั่ง INDICATOR:LEFT หรือ INDICATOR:RIGHT Arduino จะเปลี่ยน รูปแบบลูกศรให้ตรงกับทิศทางที่รถกำลังเลี้ยว การอัปเดตภาพใช้การตรวจเวลาใน loop แทนการหน่วง แบบ delay เพื่อไม่ให้การแสดงผลไปรบกวนรอบควบคุมมอเตอร์

3.3.1.5 การหยุดมอเตอร์เมื่อคำสั่งขาดช่วง

การควบคุมความเร็วแบบต่อเนื่องต้องได้รับคำสั่งจาก Raspberry Pi เป็นระยะ หากสาย USB หลุด หรือโปรแกรมส่วนบนหยุดทำงาน รถไม่ควรคงคำสั่งความเร็วล่าสุดไว้ โค้ดที่ 3.5 จึงตรวจเวลานับจาก คำสั่ง V: ครั้งล่าสุด และสั่งหยุดเมื่อเกิน 300 มิลลิวินาที

// Safety Watchdog: หากไม่ได้รับคำสั่ง V: ภายใน 300ms ให้หยุดมอเตอร์ทันที
if (millis() - lastVelocityCmdTime > VELOCITY_TIMEOUT_MS) {
targetLeftSpeed = 0.0f;
targetRightSpeed = 0.0f;
driveMotors(0, 0);
currentCmd = CMD_IDLE;
return;
}

โค้ดที่ 3.5 เงื่อนไขหยุดมอเตอร์เมื่อขาดคำสั่ง

Watchdog นี้ทำงานอยู่ใน Arduino โดยตรง จึงยังหยุดมอเตอร์ได้แม้ Raspberry Pi ไม่สามารถ ส่งคำสั่ง STOP มาในขณะนั้น นอกจากนี้โปรแกรมยังตรวจความผิดปกติเมื่อ Encoder ไม่เคลื่อนที่ตามที่สั่ง เพื่อไม่ให้มอเตอร์พยายามขับต่อโดยไม่มีความคืบหน้า

### 3.3.2 โปรแกรมควบคุมบน Raspberry Pi

3.3.2.1 การรับข้อมูล Serial จาก Arduino

Raspberry Pi เปิดพอร์ต USB Serial ที่ความเร็ว 115,200 บิตต่อวินาที แล้วอ่านข้อความทีละบรรทัด โปรแกรมแยกชนิดข้อมูลจากคำนำหน้า โดย ENCODER: ใช้ปรับค่าการเคลื่อนที่ ส่วน KEY: ใช้ส่งปุ่มเข้า POS ตัวอย่างโค้ดที่ 3.6 แสดงการตรวจปุ่มที่ได้รับก่อนเผยแพร่เข้า ROS 2 topic /keypad/key

elif line.startswith("KEY:"):
key = line[4:].strip().upper()
if len(key) == 1 and key in "0123456789ABCD*#":
message = String()
message.data = key
self._keypad_pub.publish(message)
logger.info("Arduino keypad: %s", key)
else:
logger.warning("Malformed keypad line from Arduino: %r", line)

โค้ดที่ 3.6 การตรวจปุ่มจาก Arduino และส่งต่อให้ POS

การตรวจความยาวและชุดอักขระที่อนุญาตทำให้ข้อความเสียหรือข้อมูลจากเฟิร์มแวร์ที่ไม่ตรงรูปแบบไม่ถูกนำไปใช้เป็นคำสั่งผู้ใช้ ส่วนข้อมูล ENCODER: จะถูกแยกเป็นตัวเลขซ้าย–ขวาแล้วนำไปอัปเดต odometry ซึ่งเป็นค่าตำแหน่งและมุมหันที่ระบบนำทางใช้ต่อไป

3.3.2.2 ระบบ POS และการรับรายการส่งอาหาร

จอสัมผัสเป็นช่องทางหลักในการเลือกชั้นวางและโต๊ะปลายทาง ส่วน Keypad เป็นช่องทางสำรอง
ที่แก้ไขรายการชุดเดียวกันบน POS เมื่อผู้ใช้ยืนยันว่าจัดอาหารพร้อมแล้ว ระบบจึงสร้างภารกิจให้ FSM รับไปทำงาน ไม่ได้ใช้เซนเซอร์ตรวจว่ามีอาหารวางอยู่จริงบนชั้น การยืนยันรับอาหารที่โต๊ะก็ใช้การกดบน จอหรือ Keypad เช่นเดียวกัน

ปุ่ม | หน้าที่ขณะรอรับรายการ | หน้าที่เมื่อถึงโต๊ะ
A / B | เลือกชั้น 2 / ชั้น 1 | ไม่เปลี่ยนภารกิจ
1 / 2 | เลือกโต๊ะ 1 / โต๊ะ 2 ให้ชั้นที่เลือก | ไม่เปลี่ยนภารกิจ
C | เปลี่ยนสถานะยืนยันว่ามีอาหารบนชั้น | ไม่เปลี่ยนภารกิจ
D / * | ล้างรายการชั้นที่เลือก / ล้างทั้งหมด | ไม่เปลี่ยนภารกิจ
# | เริ่มภารกิจเมื่อรายการพร้อม | ยืนยันว่ารับอาหารแล้ว

ตารางที่ 3.2 ความหมายของปุ่ม Keypad ตามสถานะ POS

เมื่อระบบอยู่ในสถานะ ERROR ปุ่ม * ใช้ขอรีเซ็ตภารกิจ แต่ในสถานะเดินทางปุ่มอื่นจะไม่เปลี่ยน รายการส่งอาหาร วิธีนี้ลดโอกาสกดผิดขณะรถกำลังเคลื่อนที่ ผู้ใช้ยังมองเห็นสถานะที่หน้าจอ POS แม้เลือก ป้อนข้อมูลผ่าน Keypad

3.3.2.3 การจัดลำดับงานด้วย FSM

ภารกิจหนึ่งงานอาจมีอาหารบนชั้นวางทั้งสองชั้น โปรแกรมจึงต้องจำว่ากำลังส่งรายการใด อยู่ที่โต๊ะ ไหน และควรไปต่อหรือกลับจุดเริ่มต้น FSM แยกการทำงานเป็นรอรับรายการ เดินทาง รอยืนยันรับอาหาร ตรวจรายการที่เหลือ กลับสถานี และข้อผิดพลาด โดยก่อนทำขั้นตอนใดจะตรวจคำขอยกเลิกก่อน ดังโค้ดที่ 3.7

def _step(self) -> None:
if self._pos.cancel_event.is_set():
self._finish_cancelled()
return
match self._state:
case State.WAIT_FOR_POS:
self._state_wait_for_pos()
case State.DELIVERING:
self._state_delivering()
case State.WAIT_PICKUP:
self._state_wait_pickup()
case State.CHECK_REMAIN:
self._state_check_remain()
case State.RETURN_STATION:
self._state_return_station()
case State.ERROR:
self._state_error()

โค้ดที่ 3.7 การเลือกขั้นตอนตามสถานะของ FSM

หลังถึงโต๊ะ ระบบหยุดรถและรอให้ผู้ใช้ยืนยันการรับอาหาร เมื่อได้รับการยืนยันแล้วจะรออีก 5 วินาทีก่อนเริ่มเคลื่อนที่ เพื่อให้ผู้ใช้มีเวลาหยิบอาหารและถอยจากรถ จากนั้นจึงตรวจว่ามีโต๊ะถัดไปหรือไม่ หากไม่มี จะเปลี่ยนเป็นการเดินทางกลับ สถานะที่ POS แสดง เช่น PREPARING และ PICKUP_DELAY เป็นช่วงย่อยเพิ่มเติมจากสถานะภายในของ FSM

3.3.2.4 การนำทางตาม Waypoint

เส้นทางต้นแบบกำหนดจุดเริ่มต้น จุดแยก และโต๊ะสองฝั่งไว้ล่วงหน้า ก่อนออกเดินทางโปรแกรม
บันทึกมุมหันเริ่มต้นของรถไว้เป็นแกนอ้างอิง เมื่อเลือกโต๊ะ 1 จะเลี้ยวไปด้านหนึ่งของทางแยก ส่วนโต๊ะ 2 จะเลี้ยวไปอีกด้าน ระยะเดินทางแต่ละช่วงวัดจาก odometry ที่คำนวณด้วย Encoder โค้ดที่ 3.8 แสดงลำดับเดินทางจากจุดเริ่มต้นไปถึงโต๊ะ

side = 1.0 if table_id == 1 else -1.0
target_heading = normalize_angle(self._start_heading + side * math.pi / 2.0)
target_distance = TABLE1_Y if table_id == 1 else TABLE2_Y

if self._location == "home":
if not self.drive_forward(JUNCTION_X, self._start_heading):
return False
if not self.turn_to_heading(target_heading):
return False
if not self.drive_forward(target_distance, target_heading):
return False

โค้ดที่ 3.8 การเดินทางผ่านจุดแยกไปยังโต๊ะปลายทาง

โปรแกรมสั่งเดินหน้าจากจุดเริ่มต้นถึงจุดแยก หมุนไปทางโต๊ะที่เลือก แล้วเดินหน้าอีกช่วงหนึ่ง หากขั้นตอนใดไม่สำเร็จจะคืนค่าความล้มเหลวให้ FSM หยุดภารกิจ การปรับค่าระยะของสนามทำได้ในไฟล์ config.py ก่อนทดสอบกับพื้นที่จริง จึงไม่ควรถือว่าค่าตั้งต้นใช้ได้กับทุกสถานที่

3.3.2.5 การตรวจสิ่งกีดขวางด้วย LiDAR

LiDAR ส่งข้อมูลระยะรอบตัวรถให้ Raspberry Pi โปรแกรมความปลอดภัยเลือกตรวจเฉพาะ มุมด้านหน้าที่สัมพันธ์กับทิศทางการวิ่ง โดยข้ามข้อมูลที่เป็น NaN, infinity หรือใกล้ตัวรถผิดปกติ ค่าตั้ง ต้นกำหนดระยะหยุด 0.30 เมตร และต้องพบจุดที่เข้าเงื่อนไขอย่างน้อยสามจุดเพื่อลดการหยุดจาก สัญญาณรบกวนเพียงจุดเดียว

if abs(robot_angle) <= half_cone_rad:
if dist <= self.stop_distance_m:
obstacle_count += 1
if dist < min_dist:
min_dist = dist
min_angle = math.degrees(robot_angle)

if obstacle_count >= self.min_obstacle_points:
if not self._obstacle_detected:
logger.warning(
f"[LiDAR Safety] OBSTACLE DETECTED at {min_dist:.2f}m ({min_angle:.1f}°)"
)
self._obstacle_detected = True
self._closest_distance = min_dist
self._closest_angle_deg = min_angle

โค้ดที่ 3.9 การตรวจระยะสิ่งกีดขวางด้านหน้า

เมื่อพบสิ่งกีดขวางระหว่างเดินหน้า โปรแกรมนำทางจะสั่งหยุดมอเตอร์และรออยู่ในช่วงเส้นทางเดิม โดยยังคงรับข้อมูล LiDAR ต่อ หากทางโล่งจึงสั่งเดินหน้าจากระยะที่เหลือ การหยุดดังกล่าวไม่เปลี่ยนสถานะ FSM หลักหรือถือว่าหุ่นยนต์เดินทางถึงโต๊ะแล้ว ลำดับการหยุดและเดินต่อแสดงในรูปที่ 21

การหยุดและเดินต่อเมื่อ LiDAR พบสิ่งกีดขวาง

รูปที่ 21 แผนภาพการหยุดและเดินต่อเมื่อ LiDAR พบสิ่งกีดขวาง

3.3.2.6 ROS 2 และการใช้ SLAM

ROS 2 ใช้เป็นช่องทางแลกเปลี่ยนข้อมูลระหว่างส่วนรับ LiDAR, odometry และชุดคำสั่งเคลื่อนที่ ข้อมูลสแกนและตำแหน่งที่ได้ยังนำไปใช้กับ SLAM เพื่อสร้างหรือแสดงแผนที่ระหว่างการพัฒนา อย่างไรก็ตาม ภารกิจส่งอาหารของต้นแบบนี้ยังเดินตามเส้นทาง Waypoint ที่กำหนดไว้ ไม่ได้ให้ SLAM หรือ Nav2 เลือกเส้นทางไปโต๊ะโดยอัตโนมัติ การแยกบทบาทนี้ช่วยให้รายงานอธิบายความสามารถของระบบตรงกับสิ่งที่
โปรแกรมทำจริง

### 3.3.3 รูปแบบข้อมูลที่ใช้สื่อสารระหว่าง Raspberry Pi กับ Arduino

3.3.3.1 ช่องทางเชื่อมต่อและรูปแบบข้อความ

Raspberry Pi 4 เชื่อมต่อกับ Arduino Uno ผ่านสาย USB โดยใช้การสื่อสารแบบ Serial ที่อัตรา 115,200 บิตต่อวินาที ข้อมูลที่แลกเปลี่ยนเป็นข้อความหนึ่งบรรทัดต่อหนึ่งรายการ และปิดท้ายด้วยอักขระขึ้น บรรทัดใหม่ (\n) ตัวอย่างเช่น V:0.250,0.250\n โปรแกรม Arduino อ่านข้อความจนถึงตัวจบบรรทัดแล้ว จึงพิจารณาคำนำหน้า ส่วน Raspberry Pi อ่านข้อความตอบกลับทีละบรรทัดในลักษณะเดียวกัน วิธีนี้ทำให้ ตรวจสอบข้อมูลได้จากหน้าต่าง Serial และแยกประเภทข้อมูลได้โดยไม่ต้องถอดรหัส

การอ่าน Keypad ผ่าน I2C เป็นการเชื่อมต่อเฉพาะระหว่าง Arduino กับโมดูล PCF8574 โดยใช้ขา A4 (SDA) และ A5 (SCL) ไม่ได้เป็นสายสื่อสารระหว่าง Raspberry Pi กับ Arduino เมื่อ Arduino ตรวจพบ การกดปุ่มแล้วจึงเปลี่ยนเหตุการณ์นั้นเป็นข้อความ KEY:<ปุ่ม> เพื่อส่งผ่าน USB Serial ไปยัง Raspberry Pi

ข้อความหลายชนิดใช้พอร์ต Serial เส้นเดียวกัน จึงอาจได้รับค่า Encoder หรือปุ่ม Keypad ระหว่างที่กำลังรอผลคำสั่งเคลื่อนที่ โปรแกรมฝั่งรับต้องตรวจคำนำหน้า ENCODER:, KEY: และ STATUS: ก่อนนำข้อมูลไปใช้

3.3.3.2 คำสั่งจาก Raspberry Pi ไปยัง Arduino

Raspberry Pi ส่งคำสั่งให้ Arduino ควบคุมมอเตอร์และไฟแสดงทิศทางตามภารกิจที่กำลังทำ ตารางที่ 3.3 สรุปรูปแบบคำสั่งและผลตอบกลับ โดยคำสั่งความเร็วต่อเนื่องใช้หน่วยเมตรต่อวินาที ส่วนคำสั่ง เดินหน้าและหมุน เป็นคำสั่งแบบมีเป้าหมายที่ Arduino แจ้งเมื่อทำเสร็จ

คำสั่ง | ตัวอย่าง | การทำงานและผลตอบกลับ
V:<ซ้าย>,<ขวา> | V:0.250,0.250 | กำหนดความเร็วล้อซ้ายและขวา หน่วย m/s; ค่าติดลบคือทิศกลับ ต้องส่งซ้ำระหว่างวิ่ง คำสั่งนี้ไม่มีข้อความตอบรับเฉพาะ
FORWARD:<เมตร> | FORWARD:1.250 | วิ่งตรงตามระยะที่กำหนด โดย firmware รับค่ามากกว่า 0 แต่น้อยกว่า 20 เมตร; เมื่อเสร็จส่ง STATUS:DONE
TURN:<องศา> | TURN:-90.0 | หมุนตามมุมที่กำหนด ค่าบวกคือเลี้ยวซ้ายหรือทวนเข็มนาฬิกา ค่าลบคือเลี้ยวขวาหรือตามเข็มนาฬิกา; เมื่อเสร็จส่ง STATUS:DONE
INDICATOR:<ทิศ> | INDICATOR:LEFT | กำหนดลูกศร LEFT, RIGHT หรือ OFF บน MAX7219; ค่าถูกต้องตอบ STATUS:INDICATOR
STOP | STOP | หยุดมอเตอร์ ยกเลิกคำสั่งที่กำลังทำ และล้าง motion fault; ตอบ STATUS:DONE

ตารางที่ 3.3 คำสั่งที่ Raspberry Pi ส่งไปยัง Arduino Uno

ขณะควบคุมความเร็วต่อเนื่อง Raspberry Pi ส่ง V: เป็นระยะ หากต้องการหยุดและล้าง fault สามารถส่ง V:0.000,0.000 ได้ แต่คำสั่งนี้ไม่ส่ง STATUS:DONE กลับมา ต่างจาก STOP ที่มีข้อความตอบรับ หาก Arduino ไม่ได้รับ V: ใหม่ภายใน 300 มิลลิวินาที จะสั่งหยุดมอเตอร์โดยอัตโนมัติ เงื่อนไขนี้เป็นชั้น ป้องกันกรณีการสื่อสารขาดช่วง ไม่ใช่ตัวแทนการตรวจสิ่งกีดขวางด้วย LiDAR

3.3.3.3 ข้อมูลและสถานะที่ Arduino ส่งกลับ

Arduino ส่งข้อมูลการหมุนของล้อ เหตุการณ์จาก Keypad และสถานะการทำงานกลับผ่านพอร์ต เดียวกัน ค่า Encoder เป็นจำนวน tick สะสมของล้อซ้ายและขวา ส่งทุก 100 มิลลิวินาที ส่วน KEY: ส่งเมื่อพบการกดปุ่มใหม่ ไม่ใช่ข้อมูลที่ส่งซ้ำทุกครั้งที่โปรแกรมวนรอบ ตารางที่ 3.4 แสดงความหมายของ ข้อความแต่ละประเภท

ข้อมูลจาก Arduino | ตัวอย่าง | ความหมาย
ENCODER:<ซ้าย>,<ขวา> | ENCODER:1234,-1228 | จำนวน tick สะสมของล้อซ้ายและขวา เป็นจำนวนเต็มมีเครื่องหมาย ใช้คำนวณ odometry
KEY:<ปุ่ม> | KEY:A | อักขระจาก Keypad ที่กดใหม่ อยู่ในชุด 0–9, A–D, * และ # แล้วส่งต่อให้ POS
STATUS:READY | STATUS:READY | Arduino เริ่มทำงานและพร้อมรับคำสั่ง
STATUS:DONE | STATUS:DONE | คำสั่ง FORWARD:, TURN: หรือ STOP ทำงานเสร็จ
STATUS:INDICATOR | STATUS:INDICATOR | รับคำสั่งไฟเลี้ยวที่ถูกต้องแล้ว
STATUS:ERROR | STATUS:ERROR | คำสั่งไม่รู้จัก หรือข้อมูลคำสั่งถูกปฏิเสธ
STATUS:STALL | STATUS:STALL | พบว่ามอเตอร์ถูกสั่งให้เคลื่อนที่ แต่ Encoder ไม่คืบหน้าตามเกณฑ์ จึงตัดกำลังขับ

ตารางที่ 3.4 ข้อมูลที่ Arduino Uno ส่งกลับไปยัง Raspberry Pi

เมื่อได้รับ STATUS:STALL ระบบต้องไม่ปล่อยให้รถทำงานต่อจากคำสั่งเดิม การล้าง fault ของ firmware ทำได้ด้วย STOP หรือคำสั่งความเร็วศูนย์ จากนั้นจึงตรวจสาเหตุ เช่น ล้อติดขัด สาย Encoder หลวม หรือแรงดันจ่ายมอเตอร์ไม่เพียงพอ ก่อนเริ่มการเคลื่อนที่อีกครั้ง ส่วน STATUS:ERROR บอกว่าคำสั่ง ไม่ถูกต้อง แต่ไม่ได้ระบุรายละเอียดข้อผิดพลาดเป็นรหัสแยก

3.3.3.4 การนำโปรโตคอลไปใช้ในโปรแกรมควบคุม

ระบบรองรับการควบคุมสองทิศทางที่ใช้โปรโตคอล Serial ชุดเดียวกัน เมื่อเริ่มระบบด้วยโหมด ROS (MOTION_BACKEND=ros) โปรแกรม slam_bridge.py เป็นผู้ถือพอร์ต Arduino รับคำสั่งความเร็วจาก ROS 2 topic /cmd_vel แล้วแปลงเป็นความเร็วล้อซ้ายและขวาในรูป V: ส่วนคำสั่งไฟเลี้ยวถูกส่งในรูป INDICATOR: ในโหมด Serial โดยตรง (MOTION_BACKEND=serial) โปรแกรม MotionClient ส่ง V: ระหว่างควบคุมต่อเนื่อง และสามารถใช้ FORWARD:, TURN: หรือ STOP สำหรับการสั่งเป็นช่วงได้ การเรียก main.py โดยไม่ระบุ backend มีค่าเริ่มต้นเป็นโหมด Serial ขณะที่สคริปต์เริ่มระบบ start_robot.sh เลือกโหมด ROS

ชื่อ topic ของ ROS 2 เป็นช่องทางสื่อสารภายใน Raspberry Pi ไม่ใช่ข้อความที่วิ่งบนสาย USB ตัวอย่างเช่น เมื่อ Arduino ส่ง KEY:A โปรแกรม bridge ตรวจรูปแบบแล้วเผยแพร่ปุ่มไปยัง /keypad/key เพื่อให้ POS เลือกชั้นวางตามสถานะขณะนั้น ส่วน ENCODER: ถูกแปลงเป็นข้อมูล odometry สำหรับการนำทาง การแยกหน้าที่เช่นนี้ทำให้โปรแกรมบน Raspberry Pi ตัดสินใจระดับภารกิจได้ โดย Arduino ยังคงควบคุมมอเตอร์และอ่านสัญญาณฮาร์ดแวร์ตามรอบเวลาของตนเอง

### 3.4 ขั้นตอนการประกอบและตรวจสอบระบบ

การประกอบเริ่มจากฐานรถและระบบไฟก่อน เพื่อให้ตรวจจุดที่มีแรงดันสูงกว่าส่วนลอจิกได้ง่าย ติดตั้งมอเตอร์ ล้อ และ L298N แล้วแยกเส้นทางจ่ายไฟ 12 V สำหรับมอเตอร์ออกจากไฟที่ลดแรงดันแล้ว สำหรับ Raspberry Pi, Arduino และอุปกรณ์แสดงผล ต่อกราวด์ร่วมเฉพาะส่วนที่ต้องอ้างอิงสัญญาณร่วมกัน และวัดแรงดันที่ปลายสายก่อนเสียบเข้าบอร์ดทุกครั้ง

หลังจากนั้นต่อ Encoder เข้าขา A0–A3 ต่อ Keypad ผ่าน PCF8574 เข้ากับ A4/A5 และต่อ MAX7219 เข้าขา D4–D6 ก่อนเชื่อม Arduino กับ Raspberry Pi ด้วย USB การตรวจทีละส่วนควรเริ่ม
จากดูว่าระบบมองเห็นพอร์ต USB และที่อยู่ I2C 0x20 หรือไม่ แล้วทดสอบปุ่ม Keypad, ลูกศรบนจอ, ค่า Encoder และทิศทางมอเตอร์โดยยังไม่วางอาหารบนรถ

เมื่ออุปกรณ์เดี่ยวทำงานครบ จึงเปิด POS และโปรแกรมควบคุมบน Raspberry Pi ทดลองกำหนด
ชั้นวางและโต๊ะปลายทาง ตรวจว่าปุ่มจากทั้งจอสัมผัสและ Keypad เปลี่ยนรายการเดียวกัน ทดสอบเดินทาง ตาม Waypoint ในพื้นที่จำลอง และนำสิ่งกีดขวางเข้า–ออกจากมุมด้านหน้า LiDAR เพื่อตรวจการหยุด และเดินทางต่อ จากนั้นทดสอบการยืนยันรับอาหาร การไปโต๊ะถัดไป และการกลับจุดเริ่มต้น

# ภาคผนวก

## ภาคผนวก ก การวิเคราะห์ต้นทุน

การวิเคราะห์ต้นทุน (NRE – Non-Recurring Engineering)

ในการพัฒนาระบบหุ่นยนต์ส่งอาหารอัตโนมัติ (Food Delivery Robot) มีการประเมินต้นทุน
การออกแบบและพัฒนาที่ไม่เกิดซ้ำ หรือ Non-Recurring Engineering (NRE) รวมประมาณ 13,750 บาท ต้นทุนดังกล่าวเกิดจากงานพัฒนาต้นแบบหลายขั้นตอน เริ่มตั้งแต่การออกแบบวงจรและกำหนดการเชื่อมต่อ
ระหว่าง Raspberry Pi, Arduino Uno, วงจรขับมอเตอร์ และอุปกรณ์ต่อพ่วง ตามด้วยการพัฒนาโปรแกรม บน Arduino สำหรับควบคุมมอเตอร์ อ่านค่า Encoder และ Keypad รวมถึงแสดงสถานะผ่านจอ Dot Matrix ส่วนโปรแกรมบน Raspberry Pi ครอบคลุมระบบ POS การจัดลำดับภารกิจส่งอาหาร การสื่อสารกับ Arduino และการควบคุมการเดินทางไปยังโต๊ะที่กำหนด

นอกจากนี้ ยังมีงานออกแบบและประกอบโครงสร้างหุ่นยนต์ต้นแบบ เพื่อใช้ติดตั้งชั้นวาง มอเตอร์ และอุปกรณ์ควบคุม เมื่อประกอบระบบแล้วต้องทดสอบการเคลื่อนที่ การส่งอาหารตามลำดับ และการหยุด รถเมื่อ LiDAR พบสิ่งกีดขวาง รวมถึงปรับแก้ปัญหาที่พบระหว่างทดสอบ การจัดทำรายงานและบันทึกผลการ ทดสอบเป็นอีกส่วนหนึ่งของงานพัฒนาต้นแบบที่นำมาคิดรวมในต้นทุน NRE

ดังนั้น ต้นทุน NRE ประมาณ 13,750 บาทจึงเป็นต้นทุนที่ประเมินสำหรับการออกแบบและพัฒนา
ต้นแบบครั้งแรก หากนำแบบและโปรแกรมเดิมไปสร้างหุ่นยนต์เพิ่มเติม ต้นทุนส่วนนี้สามารถเฉลี่ยไปตาม
จำนวนเครื่องที่ผลิต ทำให้ต้นทุนการพัฒนาเฉลี่ยต่อเครื่องลดลง ทั้งนี้ ตัวเลขดังกล่าวเป็นการประเมินมูลค่า
งานพัฒนา ไม่ใช่ยอดเงินที่จ่ายจริง และยังไม่รวมราคาวัสดุอุปกรณ์ที่ใช้ประกอบหุ่นยนต์แต่ละเครื่อง

รายละเอียดค่าใช้จ่ายในการพัฒนาครั้งเดียว (Non-Recurring Engineering: NRE) คิดเป็นเงิน ประมาณ 25,850 บาท

1. ออกแบบวงจรไฟฟ้าและระบบ Embedded System

งาน: กำหนดโครงสร้างระบบ เลือกอุปกรณ์ และออกแบบการเชื่อมต่อระหว่าง Raspberry Pi, Arduino Uno, วงจรขับมอเตอร์ และอุปกรณ์ต่อพ่วง

เวลา: 12 ชั่วโมง × 125 บาท/ชั่วโมง

รวม = 1,500 บาท

2. พัฒนาโปรแกรมควบคุม Arduino Uno งาน: เขียนและปรับโปรแกรมควบคุมมอเตอร์ อ่านค่า Encoder และ Keypad รวมถึงแสดงสถานะ ผ่านจอ Dot Matrix

เวลา: 20 ชั่วโมง × 125 บาท/ชั่วโมง

รวม = 2,500 บาท

3. พัฒนาระบบ POS และโปรแกรมควบคุมภารกิจ งาน: พัฒนาหน้าจอรับรายการ ระบบจัดลำดับการส่งอาหารแบบ FSM และการสื่อสารระหว่าง Raspberry Pi กับ Arduino Uno

เวลา: 25 ชั่วโมง × 125 บาท/ชั่วโมง

รวม = 3,125 บาท

4. พัฒนาและปรับระบบนำทาง

งาน: ตั้งค่า ROS 2 และ Waypoint เชื่อมต่อ LiDAR เพื่อตรวจสิ่งกีดขวาง และปรับการเคลื่อนที่
ของหุ่นยนต์ในพื้นที่ทดสอบ

เวลา: 20 ชั่วโมง × 125 บาท/ชั่วโมง

รวม = 2,500 บาท

5. ออกแบบและประกอบโครงสร้างหุ่นยนต์ต้นแบบ

งาน: จัดวางอุปกรณ์ ติดตั้งมอเตอร์ ชั้นวางอาหาร และโครงสร้างสำหรับทดสอบการใช้งาน

เวลา: 10 ชั่วโมง × 125 บาท/ชั่วโมง

รวม = 1,250 บาท

6. ประกอบวงจรและทดสอบระบบร่วมกัน

งาน: เดินสาย ติดตั้งอุปกรณ์ โหลดโปรแกรม ทดสอบการทำงานร่วมกัน และแก้ไขปัญหาที่พบระหว่างทดสอบ

เวลา: 15 ชั่วโมง × 125 บาท/ชั่วโมง

รวม = 1,875 บาท

7. จัดทำเอกสารและแผนการทดสอบ

งาน: จัดทำรายงาน บันทึกผลการทดสอบ และตรวจสอบขั้นตอนการทำงานของระบบ

เวลา: 8 ชั่วโมง × 125 บาท/ชั่วโมง

รวม = 1,000 บาท

รวมเวลา 110 ชั่วโมง คิดเป็นค่า NRE ประมาณ 13,750 บาท

หมายเหตุ: การประมำณค่าใช้จ่าย NRE (Non-Recurring Engineering) ในรายงานฉบับนี้ เป็นการประเมิน
เบื้องต้นเพื่อประกอบการศึกษาและวิเคราะห์เท่านั้น ตัวเลขที่แสดงมิได้มีผลผูกพันเชิงพาณิชย์หรือทำง
บัญชีโดยตรง

รายละเอียด unit cost metrics คิดเป็นราคา 13,008 บาท

วัสดุ และอุปกรณ์ | จำนวน | ราคาต่อหน่วย | ราคารวม (บาท)
Step Down DC-DC 10A Buck Step-down | 1 | 118 | 118
แกนต่อมอเตอร์หกเหลี่ยม Extended motor shaft 30mm [6mm] | 4 | 33 | 132
UNO R3 แบบถอดชิปได้ พร้อมสาย USB | 1 | 159 | 159
ABS Case พร้อมพัดลม สำหรับ Raspberry Pi 4 (OEM) | 1 | 200 | 200
Kingston microSD Card 64GB Canvas Select Plus | 1 | 590 | 590
ZENOVA แบตเตอรี่ลิเธียม 12V ความจุ 15Ah + เครื่องชาร์จ | 1 | 383 | 383
RPLIDAR A1M8-R6 - 360 Degree Laser Scanner | 1 | 3,585 | 3,585
Raspberry Pi 4 Model B Single Board Computer 4GB | 1 | 4,450 | 4,450
สวิทช์ DC 12V | 1 | 29 | 29
L298N Motor Driver Module | 1 | 80 | 80
PCF8574 | 1 | 50 | 50
Keypad Matrix 4x4 | 1 | 20 | 20
LED Matrix 32x8 | 1 | 148 | 148
Arduino UNO Terminal Shield | 1 | 82 | 82
Bus Bar ขนาด 14 ช่อง | 2 | 45 | 90
Bus Bar ขนาด 5 ช่อง | 1 | 25 | 25
มอเตอร์ DC Encoder JGB37-520 | 2 | 182 | 364
ล้อยางขนาด 130 mm | 2 | 168 | 335
มอดูลอ่านความจุแบตเตอรี่ Rideon DC 8V-72V | 1 | 81 | 81
หน้าจอสัมผัส Aprotii LCD DHMI 7 นิ้ว | 1 | 1,000 | 1,000
สาย Micro HDMI to HDMI ยาว 1.5 m | 1 | 137 | 137
สาย Micro USB to USB A ยาว 2 m | 1 | 86 | 86
สาย USB B to USB A ยาว 2 m | 1 | 55 | 55
อลูมิเนียมโปรไฟล์ 20x20 ยาว 1 m | 1 | 205 | 205
ข้อต่ออลูมิเนียมโปรไฟล์ | 8 | 13 | 104
แผ่นอาคลีลิก หนา 5 mm ขนาด 60 x 60 cm | 1 | 200 | 200
ชั้นวางอเนกประสงค์ | 1 | 250 | 250
สายไฟจัมเปอร์ | | | 200
น็อต สกรู | | | 100
รวมทั้งสิ้น | | | 13,258

ราคา unit cost metrics รวมเป็นเงิน 13,258 บาท

ดังนั้น เมื่อได้ NRE cost และ unit cost แล้วจะสามารถนำมาคำนวณต้นทุน เพื่อหาราคาขายได้ โดยต้นทุน NRE เป็นต้นทุนคงที่ (Fixed Cost) ที่เกิดขึ้นครั้งเดียว เมื่อผลิตจำนวนมากขึ้น ต้นทุน NRE ต่อเครื่องจะถูกเฉลี่ยลดลง

ต้นทุนต่อเครื่อง=Unit Cost+(NRE)/(จำนวนเครื่องที่วางแผนผลิต (Q))

- กรณีผลิตเครื่องเดียว (ทำเป็นต้นแบบ/Custom Made 1 เครื่อง):
  - ต้นทุน = 13,258+13,750=27,008 บาท
- กรณีผลิตล็อตเล็ก (Batch เล็ก เช่น 5 เครื่อง):
  - ค่า NRE ต่อเครื่อง = (13,750)/5=2,750 บาท
  - ต้นทุน = 13,258+2,750=16,008 บาท/เครื่อง
- กรณีผลิต 10 เครื่อง:
  - ค่า NRE ต่อเครื่อง = (13,750)/10=1,375 บาท
  - ต้นทุน = 13,258+1,375=14,633 บาท/เครื่อง
- กรณีผลิตจำนวนมาก (เช่น 50 เครื่องขึ้นไป):
  - ค่า NRE ต่อเครื่องจะเหลือเพียง (13,750)/50≈275 บาท ต้นทุนจะใกล้เคียง 13,500 บาท/เครื่อง

หากต้องการตั้งราคาขายแบบขายเครื่องเมื่อต้องการ margin กำไร ที่ประมาณ 70 % จะคำนวณราคาขายได้ดังนี้

- กรณีผลิตเครื่องเดียว
  - ราคาต้นทุน 27,008 บาท
  - กำไรที่ต้องการ 70% จะได้ 170/100×27,008=45,913 บาท
- กรณีผลิต 50 เครื่องขึ้นไป
  - ราคาต้นทุน 13,500 บาท
  - กำไรที่ต้องการ 70% จะได้ 170/100×13,500=22,950 บาท

เห็นได้ว่าจำนวนการผลิตนั้นส่งผลต่อราคาขายเป็นอย่างมาก ดังนั้นหากต้องการนำไปขายจริงในตลาดหุ่นยนต์โดยใช้โมเดลธุรกิจแบบซื้อขาด การลดต้นทน (unit cost) และการเพิ่มจำนวนการผลิต จะช่วยให้ราคาขายลดลง และดึงดูดผู้ซื้อได้มากขึ้น

## ภาคผนวก ข ภาพการทำงาน

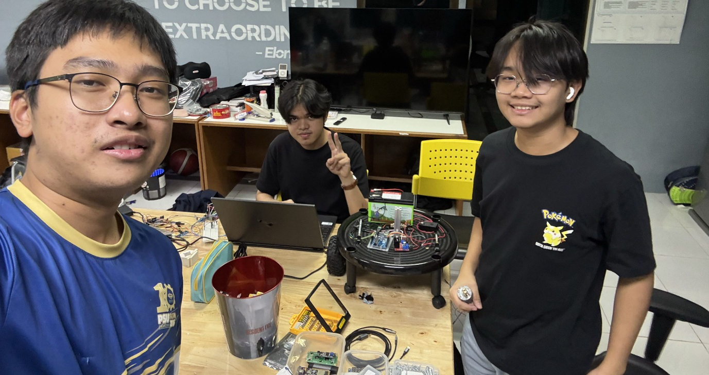
[picture p21: figure]

รูปที่ x ภาพบรรยากาศการทำงาน การประกอบชิ้นงาน หุ่นยนต์ในชั้นที่ 1

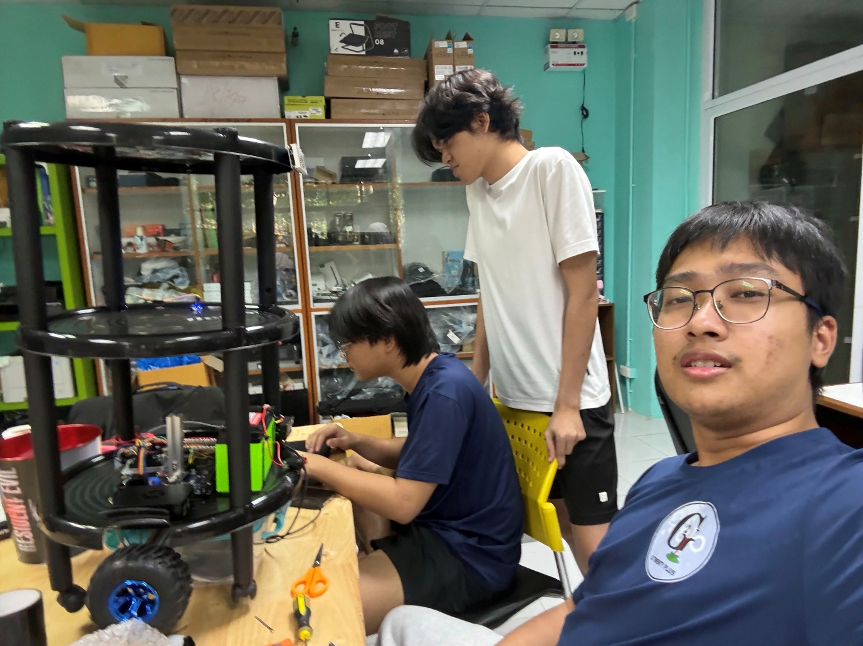
[picture p22: figure]

รูปที่ x ภาพบรรยากาศการทำงาน ประกอบชั้นวางของของหุ่นยนต์ครบทุกชั้น

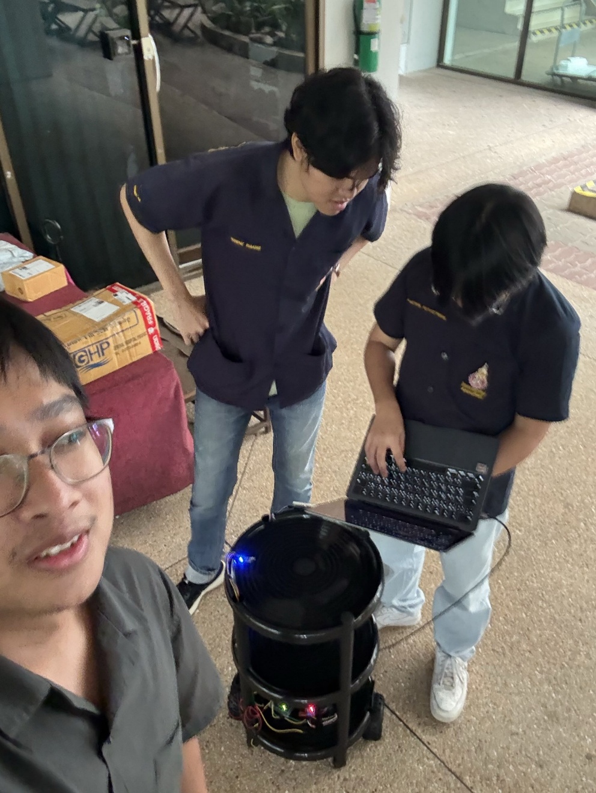
[picture p23: figure]

รูปที่ x ภาพบรรยากาศการทดสอบหุ่นยนต์ในสถานที่จำลอง บริเวณอาคารหุ่นยนต์ ใต้สาขาวิชาวิศวกรรมคอมพิวเตอร์
