AungpaoK/EmbeddedProj/docs/report/รายงาน embeded proj บท 1.docx

รายงาน

Mini project วิชา 240-319 Embedded System Developer Module

หุ่นยนต์เสิร์ฟอาหารอัจฉริยะ Smart Food Delivery Robot

จัดทำโดย

นายธีรภัทร | ภักดี | รหัสนักศึกษา | 6710110199 | Section 01
นายพัทธรินทร์ | กิตติพุฒิพงศ์ | รหัสนักศึกษา | 6710110282 | Section 01
นายสรวิศ | สุขการณ์ | รหัสนักศึกษา | 6710110428 | Section 01

เสนอ

รศ.ดร. | ปัญญยศ | ไชยกาฬ
ผศ.ดร. | วชรินทร์ | แก้วอภิชัย
รศ.ดร. | ทวีศักดิ์ | เรืองพีระกุล

รายงานฉบับนี้เป็นส่วนหนึ่งของรายวิชา

240-319 ชุดวิชานักพัฒนาระบบฝังตัว (EMBEDDED SYSTEM DEVELOPER MODULE)

มหาวิทยาลัยสงขลานครินทร์ วิทยาเขตหาดใหญ่

ภาคเรียนที่ 1 ปี การศึกษา 2569

บทที่ 1
บทนำ

1.1 ที่มาและความสำคัญ

ธุรกิจอาหารและเครื่องดื่มเป็นภาคธุรกิจที่มีความสำคัญต่อเศรษฐกิจไทย โดยข้อมูลธุรกิจอาหารและเครื่องดื่มที่จดทะเบียนกับกรมพัฒนาธุรกิจการค้าในปี 2567 มีรายได้รวมประมาณ 337.2 พันล้านบาท และธุรกิจร้านอาหารมีรายได้ประมาณ 308.8 พันล้านบาท หรือคิดเป็นร้อยละ 91.6 ของรายได้ธุรกิจอาหารและเครื่องดื่มที่จดทะเบียนทั้งหมด [13] ขณะเดียวกัน สำนักงานนโยบายและยุทธศาสตร์การค้ารายงานว่า ตลาดหุ่นยนต์บริการในประเทศไทยเติบโตกว่าร้อยละ 147.8 ในปี 2565 มีหุ่นยนต์บริการที่ใช้งานจริงมากกว่า 1,660 ตัว และคาดการณ์ว่าจะเพิ่มเป็น 2,270 ตัวในปี 2567 [12] โดยข้อมูลดังกล่าวเป็นภาพรวมของตลาดหุ่นยนต์บริการ มิใช่อัตราการใช้งานเฉพาะในร้านอาหาร ตัวเลขเหล่านี้สะท้อนให้เห็นถึงขนาดของอุตสาหกรรมอาหารและแนวโน้มการประยุกต์ใช้เทคโนโลยีเพื่อสนับสนุนการให้บริการ อย่างไรก็ตาม จากการศึกษายังพบปัญหาการบริการในร้านอาหารขนาดเล็กได้ เช่น การนำอาหารจากครัวไปส่งยังโต๊ะลูกค้ายังคงเป็นงานที่ต้องทำซ้ำและอาจเกิดความล่าช้าหรือความผิดพลาดได้ โดยเฉพาะในช่วงที่มีผู้ใช้บริการจำนวนมาก จึงมีความสนใจในการนำระบบอัตโนมัติมาช่วยสนับสนุนการขนส่งอาหารภายในร้าน

ระบบสมองกลฝังตัว (Embedded System) และระบบอัตโนมัติ (Automation) มีบทบาทสำคัญต่อการดำเนินชีวิตและการพัฒนาเศรษฐกิจในสังคมปัจจุบัน ระบบสมองกลฝังตัวช่วยให้อุปกรณ์ต่าง ๆ สามารถรับข้อมูลจากสภาพแวดล้อม ประมวลผลข้อมูล และตอบสนองตามเงื่อนไขที่กำหนดได้อย่างเหมาะสม ขณะที่ระบบอัตโนมัติช่วยลดขั้นตอนการทำงานที่ซ้ำซ้อน เพิ่มความสม่ำเสมอในการปฏิบัติงาน และสนับสนุนการทำงานที่ต้องการความรวดเร็วหรือความต่อเนื่อง เทคโนโลยีทั้งสองจึงถูกนำไปประยุกต์ใช้ในหลายด้าน เช่น อุตสาหกรรม การแพทย์ การคมนาคม เกษตรกรรม บ้านอัจฉริยะ และธุรกิจบริการ นอกจากช่วยเพิ่มประสิทธิภาพของกระบวนการทำงานแล้ว ยังช่วยให้มนุษย์สามารถมุ่งเน้นงานที่ต้องใช้การตัดสินใจ การดูแลผู้รับบริการ และความคิดสร้างสรรค์ได้มากขึ้น การออกแบบระบบดังกล่าวจึงควรคำนึงถึงความถูกต้อง ความปลอดภัย ความน่าเชื่อถือ ต้นทุน และความเหมาะสมกับบริบทการใช้งาน

จากความสำคัญของปัญหาและบทบาทของเทคโนโลยีดังกล่าว คณะผู้จัดทำจึงสนใจพัฒนาต้นแบบหุ่นยนต์ส่งอาหารอัตโนมัติสำหรับช่วยลำเลียงอาหารภายในพื้นที่จำลอง โดยมุ่งประยุกต์ใช้ความรู้ในขอบเขตของวิชา Embedded System Developer Module ได้แก่ ระบบสมองกลฝังตัว การควบคุมอุปกรณ์ การสื่อสารระหว่างระบบ การตรวจจับสภาพแวดล้อม และการนำทางอัตโนมัติ โครงงานนี้จึงเป็นแนวทางสำหรับศึกษาและบูรณาการเทคโนโลยีที่เกี่ยวข้องกับการพัฒนาระบบอัตโนมัติในงานบริการ ทั้งนี้ ผลงานมีลักษณะเป็นต้นแบบเพื่อการเรียนรู้และการทดสอบในพื้นที่จำลอง ยังไม่ครอบคลุมการใช้งานจริงเชิงพาณิชย์

1.2 วัตถุประสงค์

เพื่อศึกษาการประยุกต์ใช้ความรู้จากวิชา 240-319 Embedded System Developer Module มาสร้างต้นแบบหุ่นยนต์ส่งอาหาร (Food Delivery Robot) สำหรับร้านอาหารขนาดเล็ก

1.3 ขอบเขตของโครงงาน

โครงงานนี้ครอบคลุมการออกแบบและพัฒนาหุ่นยนต์ส่งอาหารต้นแบบแบบ Differential Drive สำหรับร้านอาหารขนาดเล็ก โดยทดสอบในพื้นที่จำลองภายในอาคารและใช้เส้นทางกับ ตำแหน่งที่กำหนดไว้ล่วงหน้า ระบบรองรับการเลือกชั้นวางและโต๊ะปลายทางผ่านระบบ POS หรือ Keypad รวมถึงการควบคุมการเคลื่อนที่ การสื่อสารระหว่างระบบ การตรวจจับสิ่งกีดขวาง และการยืนยันภารกิจ การประเมินจำกัดอยู่ที่การทดสอบซอฟต์แวร์ การสื่อสารระหว่างอุปกรณ์ และการเคลื่อนที่ในพื้นที่จำลอง

วัสดุ และอุปกรณ์ | จำนวน
Step Down DC-DC 10A Buck Step-down | 1
แกนต่อมอเตอร์หกเหลี่ยม Extended motor shaft 30mm [6mm] | 4
Arduino UNO R3 แบบถอดชิปได้ พร้อมสาย USB | 1
ABS Case พร้อมพัดลม สำหรับ Raspberry Pi 4 (OEM) | 1
Kingston microSD Card 64GB Canvas Select Plus | 1
ZENOVA แบตเตอรี่ลิเธียม 12V ความจุ 15Ah + เครื่องชาร์จ | 1
RPLIDAR A1M8-R6 - 360 Degree Laser Scanner | 1
Raspberry Pi 4 Model B Single Board Computer 4GB | 1
สวิทช์เปิดปิดไฟเลี้ยง | 1

1.4 ประโยชน์ที่คาดว่าจะได้รับ

1.4.1. ได้ต้นแบบหุ่นยนต์ส่งอาหารอัตโนมัติสำหรับทดสอบการทำงานในพื้นที่จำลอง เพื่อแก้ปัญหาการบริหารของพนักงานเสิร์ฟอาหาร

1.4.2. ได้ศึกษาแนวทางการประยุกต์ใช้ระบบสมองกลฝังตัวและระบบอัตโนมัติกับงานบริการ

1.4.3. ได้ฝึกการบูรณาการการควบคุม การสื่อสาร การตรวจจับสภาพแวดล้อม และการนำทางอัตโนมัติ

1.4.4. ได้แนวทางสำหรับพัฒนาระบบช่วยขนส่งอาหารในร้านอาหารขนาดเล็ก

1.4.5. ได้พื้นฐานสำหรับการพัฒนาหุ่นยนต์บริการที่มีความสามารถสูงขึ้นในอนาคต

1.5 นิยามศัพท์เฉพาะ

ระบบสมองกลฝังตัว (Embedded System) หมายถึง ระบบคอมพิวเตอร์ที่ออกแบบให้ทำงานเฉพาะด้าน โดยสามารถรับข้อมูล ประมวลผล และควบคุมอุปกรณ์ตามวัตถุประสงค์ที่กำหนด

ระบบอัตโนมัติ (Automation) หมายถึง การใช้ระบบควบคุมและเทคโนโลยีเพื่อให้กระบวนการทำงานดำเนินไปตามเงื่อนไขที่กำหนด โดยลดการควบคุมจากมนุษย์ในขั้นตอนที่ทำซ้ำ

หุ่นยนต์ส่งอาหาร (Food Delivery Robot) หมายถึง หุ่นยนต์บริการที่ใช้ช่วยลำเลียงอาหารจากจุดเตรียมอาหารไปยังจุดหมายภายในพื้นที่ที่กำหนด

Differential Drive หมายถึง รูปแบบการขับเคลื่อนที่ควบคุมความเร็วของล้อซ้ายและล้อขวาแยกจากกันเพื่อกำหนดทิศทางและการหมุนของหุ่นยนต์

Waypoint หมายถึง จุดตำแหน่งหรือจุดอ้างอิงที่กำหนดไว้บนเส้นทาง เพื่อใช้ควบคุมลำดับการเดินทางของหุ่นยนต์

Encoder หมายถึง อุปกรณ์ที่ตรวจวัดการหมุนหรือการเคลื่อนที่ของมอเตอร์และแปลงเป็นสัญญาณสำหรับใช้ประเมินระยะทางหรือความเร็ว

LiDAR หมายถึง เซนเซอร์ที่ใช้แสงเลเซอร์วัดระยะห่างจากวัตถุ เพื่อรับรู้สภาพแวดล้อมและตรวจจับสิ่งกีดขวาง

ROS 2 หมายถึง เฟรมเวิร์กสำหรับพัฒนาซอฟต์แวร์หุ่นยนต์และแลกเปลี่ยนข้อมูลระหว่างส่วนต่าง ๆ ของระบบ

SLAM หมายถึง กระบวนการที่หุ่นยนต์สร้างแผนที่ของพื้นที่พร้อมประมาณตำแหน่งของตนเองขณะเคลื่อนที่

POS/Kiosk หมายถึง ส่วนติดต่อผู้ใช้สำหรับรับรายการอาหาร เลือกจุดหมาย และจัดการข้อมูลภารกิจของหุ่นยนต์

ข้อมูลอ้างอิง

[12] สำนักงานนโยบายและยุทธศาสตร์การค้า, “สนค. เผยข้อมูลการใช้หุ่นยนต์บริการ (Service Robot),” กระทรวงพาณิชย์. [ออนไลน์]. เข้าถึงได้จาก: https://www.tpso.go.th/news/2403-0000000005

[13] Krungsri Research, “Industry Outlook: Food and Beverage Services,” Bank of Ayudhya. [ออนไลน์]. เข้าถึงได้จาก: https://www.krungsri.com/en/research/industry/industry-outlook/services/food-beverages/io/io-food-beverage-restaurant-2026
