AungpaoK/EmbeddedProj/docs/setup.md

# คู่มือตั้งค่าระบบหุ่นยนต์ส่งอาหาร

คู่มือนี้อธิบายการเริ่มระบบตามค่าใน `.env` ปัจจุบัน ซึ่งใช้ `MOTION_BACKEND=ros` โดย `slam_bridge` เป็นผู้เชื่อม ROS 2 กับ Arduino มอเตอร์ และ `main.py` เปิดหน้า POS พร้อมควบคุมภารกิจส่งอาหาร

## 1. เตรียมอุปกรณ์และซอฟต์แวร์

### อุปกรณ์

- Raspberry Pi 4 ที่เชื่อมต่อกับ Arduino Uno R3 หนึ่งบอร์ด, RPLIDAR และจอสัมผัส POS/Kiosk
- Arduino Uno ควบคุมมอเตอร์/Encoder/LED Matrix และอ่าน Keypad 4x4 ผ่าน PCF8574 ที่ A4 (SDA), A5 (SCL)
- จอสัมผัส Aprotii ขนาด 7 นิ้วต่อภาพด้วย Micro HDMI และรับข้อมูล touch ผ่าน USB; ไม่มี LCD ตัวอักษรแยก
- ก่อนทดลองสั่งวิ่ง ให้ยกล้อขับเคลื่อนพ้นพื้นหรือถอดไฟจากมอเตอร์ไดรเวอร์

### ซอฟต์แวร์

- ROS 2 Jazzy พร้อม environment setup ที่ `/opt/ros/jazzy/setup.bash`
- ROS workspace ที่ `~/ros2_ws/install/setup.bash` และแพ็กเกจ `sllidar_ros2` กับ `slam_toolbox`
- Python 3, pySerial และ `tmux`
- Arduino IDE CLI (`arduino`) เฉพาะกรณีต้องแฟลช firmware ใหม่
- Chromium/Chromium Browser หรือ Firefox สำหรับหน้า POS บนจอ Pi

หากรันผ่าน SSH และต้องการให้ POS เปิดบนจอ Pi ต้องมี desktop session ทำงานอยู่ (แนะนำเปิด auto-login desktop ด้วยผู้ใช้เดียวกับที่ SSH) สคริปต์จะเปิด kiosk ไปที่ `DISPLAY=:0` เป็นค่าเริ่มต้น และพยายามปลุกจอผ่าน `xset` หากติดตั้งไว้

## 2. ตรวจพอร์ตและตั้งค่า `.env`

เสียบอุปกรณ์แล้วดูชื่อพอร์ตแบบคงที่:

```bash
ls -l /dev/serial/by-id/
```

เพิ่มหรือแก้ค่าต่อไปนี้ในไฟล์ `.env` ที่รากโปรเจกต์ โดยแทนค่าตัวอย่างด้วยชื่อพอร์ตจริง:

```dotenv
MOTION_BACKEND=ros
MOTION_PORT=/dev/serial/by-id/<Arduino-มอเตอร์>
MOTION_SERIAL_BAUD=115200
LIDAR_PORT=/dev/serial/by-id/<LiDAR>
```

หากตั้ง `LIDAR_PORT` ไว้ สคริปต์จะใช้พอร์ตนั้น หากไม่ตั้ง ระบบจะค้นหาอุปกรณ์ LiDAR ให้อัตโนมัติเมื่อพบพอร์ตที่ตรงกันเพียงตัวเดียว

ถ้าผู้ใช้ Linux ยังไม่มีสิทธิ์ใช้พอร์ตอนุกรม ให้เพิ่มผู้ใช้ในกลุ่ม `dialout` แล้วออกจากระบบและเข้าใหม่:

```bash
sudo usermod -aG dialout "$USER"
```

พิกัดเริ่มต้นของระบบกำหนดครัวเป็น `(0, 0)` หันหน้าไปทาง `+X`, ทางแยกห่าง `2.0 m`, โต๊ะ 1 อยู่ `y=+0.6 m` และโต๊ะ 2 อยู่ `y=-0.6 m` ปรับ `JUNCTION_X`, `TABLE1_Y` และ `TABLE2_Y` ใน `.env` ให้ตรงกับพื้นที่จริงก่อนใช้งาน [ค่าพิกัดและพอร์ต](../src/config.py)

## 3. เตรียม firmware ของ Arduino

Arduino Uno ต้องใช้ firmware ใน `src/Arduino_1_Motion/Arduino_1_Motion.ino` ซึ่งรวมมอเตอร์ Encoder, MAX7219 และ Keypad แล้ว ถ้ายังไม่ได้แฟลช ให้หยุด SLAM bridge ก่อน แล้วรัน:

```bash
cd ~/EmbeddedProj
bash flash_motion.sh
```

สคริปต์ตรวจพอร์ตและคอมไพล์ก่อนอัปโหลด จากนั้นให้พิมพ์ `FLASH` เพื่อยืนยัน ตรวจสอบว่าพอร์ตที่เลือกเป็น Arduino มอเตอร์ และยกล้อพ้นพื้นหรือถอดไฟมอเตอร์ไดรเวอร์ในการทดสอบครั้งแรก [สคริปต์แฟลช firmware](../flash_motion.sh)

ต่อ PCF8574 ของ Keypad ดังนี้: VCC ไป 5V, GND ไป GND, SDA ไป A4 และ SCL ไป A5 โดยค่า Address เริ่มต้นในโค้ดคือ `0x20` ขา Encoder ปัจจุบันใช้ A0–A3 จึงไม่ชนกับบัส I2C ส่วนลำดับขา Keypad บน PCF8574 คือ Row ไป P7–P4 และ Column ไป P3–P0

### Keypad ส่งข้อมูลให้ Pi อย่างไร

Arduino อ่าน Keypad ผ่าน PCF8574 บนบัส I2C (A4/A5) ทุก 10 ms และส่งหนึ่งบรรทัดเมื่อมีการกดปุ่มใหม่ ข้อมูลที่ส่งผ่าน USB Serial เป็นข้อความ ASCII ที่ 115200 baud ในรูปแบบ `KEY:<ปุ่ม>\r\n` เช่น กด `A` จะได้ `KEY:A\r\n` และกด `#` จะได้ `KEY:#\r\n` การกดค้างไม่ได้ทำให้ส่งซ้ำทุก loop; โค้ดตั้ง debounce ไว้ 40 ms

USB Serial เส้นเดียวกันยังมีข้อความ `ENCODER:<ซ้าย>,<ขวา>` และ `STATUS:<สถานะ>` จาก Arduino ด้วย เมื่อใช้ `MOTION_BACKEND=ros` โปรแกรม `slam_bridge.py` เป็นเจ้าของพอร์ต อ่านทีละบรรทัดด้วย `readline()` แล้วแยกจากคำนำหน้า: `KEY:` จะตรวจว่ามีปุ่มเดียวในชุด `0–9`, `A–D`, `*`, `#` ก่อนเผยแพร่ตัวปุ่มไปที่ ROS topic `/keypad/key`; `main.py` รับ topic นี้แล้วส่งต่อให้ POS ตีความตามสถานะภารกิจ หากใช้ backend แบบ Serial โดยตรง `odometry.py` จะอ่าน `KEY:` แล้วส่งให้ POS โดยไม่ผ่าน ROS topic จึงห้ามเปิด Serial Monitor หรือโปรแกรมอื่นจับพอร์ต Arduino พร้อมกับระบบหลัก

ข้อมูลจากอุปกรณ์อื่นเข้าคนละทาง: LiDAR ส่งข้อมูลสแกนผ่าน ROS topic `/scan` ส่วนการกดบนหน้าจอ POS ส่งคำขอ HTTP ไปยัง POS server บน Pi ทั้งหน้าจอและ Keypad ใช้รายการที่กำลังตั้งค่าใน POS ชุดเดียวกัน

| สถานะ POS | ปุ่ม | ผลที่เกิดขึ้น |
| --- | --- | --- |
| รอรับงาน (`IDLE`/`COMPLETED`) | `A` / `B` | A เลือกชั้น 2; B เลือกชั้น 1 |
| รอรับงาน | `1` / `2` | เลือกโต๊ะ 1 / 2 ให้ชั้นที่เลือก; กดโต๊ะเดิมซ้ำเพื่อยกเลิก |
| รอรับงาน | `C` | สลับสถานะยืนยันอาหารของชั้นที่เลือก |
| รอรับงาน | `D` / `*` | ล้างรายการของชั้นที่เลือก / ล้างรายการทั้งหมด |
| รอรับงาน | `#` | เริ่มภารกิจเมื่อรายการครบ |
| รอรับการหยิบ (`WAITING_PICKUP`) | `#` | ยืนยันว่ารับอาหารแล้ว |
| ข้อผิดพลาด (`ERROR`) | `*` | ขอรีเซ็ตภารกิจ |

หมายเหตุการยืนยันอาหาร: ใน POS Server ปัจจุบัน การกำหนดโต๊ะใหม่ตั้งสถานะอาหารของชั้นนั้นเป็นยืนยันแล้ว ส่วนปุ่ม `C` ใช้สลับสถานะนี้ ให้ตรวจสถานะที่แสดงบน POS/Kiosk ก่อนกดเริ่มงาน

ในสถานะอื่นปุ่มจะไม่เปลี่ยนภารกิจ ตรวจว่าข้อมูลปุ่มถึง Pi ระหว่างที่ระบบทำงานได้ด้วย `ros2 topic echo /keypad/key` แล้วกดปุ่มหนึ่งครั้ง; ควรเห็น `data: 'A'` เมื่อกด `A` (เครื่องหมาย quote ในผลลัพธ์อาจต่างกันตาม ROS 2)

## 4. เปิดระบบทั้งหมดด้วยสคริปต์เดียว

สคริปต์รวมจะเปิด LiDAR, `slam_bridge`, ผังร้านและเส้นทางสำหรับ RViz, POS controller และ POS kiosk ใน tmux session ชื่อ `food-robot` โดยไม่ต้องค้าง SSH ไว้ ระบบใช้งานจริงเดินตามเส้นทางปิดรอบ Kitchen → Junction → Table เหมือน `start_scenario.sh`; ผังร้านเป็น visualization และไม่ได้ใช้ Nav2 วางแผนอ้อมสิ่งกีดขวาง

```bash
cd ~/EmbeddedProj
bash start_robot.sh
```

เมื่อเปิดสำเร็จ คำสั่งจะคืน prompt กลับมา แต่บริการทั้งหมดยังทำงานใน tmux หากเคยเปิด stack รุ่นเดิมด้วย `start_slam.sh` หรือเปิด POS ใน tmux ชื่อ `pos` ให้หยุด session เดิมก่อน เพื่อไม่ให้เปิด serial port ซ้ำ

ดู log ทุกโปรเซสหรือกลับเข้า session:

```bash
bash start_robot.sh status
bash start_robot.sh attach
```

ขณะอยู่ใน tmux กด `Ctrl+B` แล้ว `D` เพื่อ detach โดยไม่หยุดระบบ

POS kiosk จะเปิดบนจอ Pi ที่ `DISPLAY=:0` โดยอัตโนมัติ สคริปต์ตั้ง `XDG_RUNTIME_DIR`, หา Xauthority ของผู้ใช้ และพยายามเปิดจอจากโหมดพัก หาก desktop session ยังไม่ทำงาน หรือ SSH ด้วยคนละผู้ใช้กับ desktop ให้ตั้ง `POS_DISPLAY`, `POS_XAUTHORITY`, `POS_XDG_RUNTIME_DIR` หรือ `POS_WAYLAND_DISPLAY` ก่อนเรียกสคริปต์ เช่น:

```bash
POS_DISPLAY=:0 bash start_robot.sh
```

Firefox kiosk ใช้โปรไฟล์ชั่วคราวใหม่ทุกครั้ง แล้วลบเมื่อปิด browser เพื่อไม่ชนกับ lock ของรอบก่อน ตรวจ log การเปิดหน้าจอได้ที่ `/tmp/pos_kiosk_autostart.log`

หากต้องการควบคุมจาก terminal แทนหน้าจอสัมผัส ให้เปิด console หลังจาก stack ทำงานแล้ว:

```bash
bash start_robot.sh console
```

Console และ POS ใช้ API และสถานะภารกิจชุดเดียวกัน จึงสร้างงานพร้อมกันไม่ได้ แต่สามารถใช้ช่องทางใดช่องทางหนึ่งเพื่อสร้างงานหรือยืนยันการรับอาหารได้ เปิด RViz จากคอมด้วย:

```bash
./run_rviz2_pc.sh src/scenario_view.rviz
```

## 5. เปิดหน้า POS จากคอมผ่าน SSH tunnel

ตัว POS รับเฉพาะการเชื่อมต่อจากเครื่อง Pi (`127.0.0.1`) ถ้าต้องการดูหรือกด POS จากคอม ให้เปิด terminal บนคอมแล้วคง SSH tunnel นี้ไว้:

```bash
ssh -N -L 8765:127.0.0.1:8765 <user>@<IP-ของ-Pi>
```

จากนั้นเปิด `http://127.0.0.1:8765/` ใน browser บนคอม หน้าจอ POS บน Pi จะเปิดแยกใน kiosk ด้วย

## 6. ตรวจสอบก่อนเริ่มงาน

ใน terminal ที่ source ROS environment แล้ว ตรวจหัวข้อ ROS และ health endpoint:

```bash
ros2 topic echo /arduino/ready --once
ros2 topic echo /keypad/key
ros2 topic hz /scan
ros2 topic hz /odom
ros2 topic echo /map --once
curl http://127.0.0.1:8765/api/health
```

`/arduino/ready` ควรแสดง `data: true`, `/scan` และ `/odom` ควรมีข้อมูลต่อเนื่อง และ health endpoint ควรตอบ `{"ok": true}` จากนั้นทดลองเคลื่อนที่โดยไม่มีอาหารก่อน และตรวจว่าพิกัดทางแยกกับโต๊ะตรงกับพื้นที่จริง

ตัวควบคุม LiDAR หยุดรถเมื่อพบวัตถุในกรวยด้านหน้าและเดินต่อเมื่อทางโล่ง แต่ไม่ได้วางแผนอ้อมสิ่งกีดขวาง ระบบส่งอาหารให้ยืนยันรับอาหารผ่าน POS, Terminal console หรือปุ่ม `#` บน Keypad

## 7. ปิดระบบ

สั่งหยุดอย่างสุภาพจาก SSH:

```bash
bash ~/EmbeddedProj/start_robot.sh stop
```

## หมายเหตุ

`start_robot.sh` ต้องใช้ `MOTION_BACKEND=ros` เพราะ `slam_bridge` เป็นผู้เปิด serial ของ Arduino มอเตอร์ ห้ามรันตัวควบคุมแบบ serial หรือ teleop พร้อมภารกิจส่งอาหาร

หาก kiosk ไม่ปรากฏบนจอ ให้ยืนยันก่อนว่า Pi เข้าสู่ desktop session แล้ว และใช้ SSH ด้วยบัญชีเดียวกับ desktop จากนั้นตรวจ `/tmp/pos_kiosk_autostart.log` และค่า `POS_DISPLAY`/`POS_XAUTHORITY`

หาก Firefox แจ้งว่าเปิดอยู่แล้วแต่ไม่ตอบสนอง ให้ปิดหน้าต่างหรือโปรเซส Firefox เก่าบน Pi หนึ่งครั้ง แล้วเริ่ม kiosk ใหม่ ตัวเปิดปัจจุบันสร้างโปรไฟล์ชั่วคราวแยกในแต่ละครั้ง เพื่อลดปัญหา lock จากรอบก่อน

หาก Firefox kiosk เปิดเป็นหน้าดำบน desktop ที่ใช้ Wayland ให้ลองบังคับ Firefox Snap ผ่าน XWayland โดยเพิ่มค่านี้ใน `.env`:

```dotenv
MOZ_ENABLE_WAYLAND=0
DISABLE_WAYLAND=1
```

launcher จะอ่านพาธ Xauthority ปัจจุบันจากโปรเซส XWayland เพื่อรองรับ cookie ที่เปลี่ยนเมื่อ desktop session เริ่มใหม่ โดยปกติไม่ต้องกำหนด `POS_XAUTHORITY` เอง หากเคยใส่พาธ `.mutter-Xwaylandauth.*` แบบเจาะจงไว้ใน `.env` ให้ลบบรรทัดนั้นหลังอัปเดต launcher แล้ว หากยังเปิดไม่ได้ ให้ตรวจบรรทัด `Authorization required` ใน log และยืนยันว่า `POS_DISPLAY` ตรงกับ display ที่ XWayland ใช้ จากนั้นหยุดและเริ่ม stack ใหม่

หาก touchscreen ใช้งานได้ช่วงสั้น ๆ แล้วหยุด ให้ต่อสาย USB สำหรับข้อมูล touch เข้ากับ Pi และจ่ายไฟให้จอผ่านแหล่งจ่ายไฟของจอแยก จากการทดสอบ อุปกรณ์ touch มีการ disconnect/reconnect ขณะใช้ไฟจาก USB และทำงานต่อเนื่องเมื่อจอมีไฟเลี้ยงแยก อาการนี้ชี้ไปที่ความไม่เสถียรของไฟเลี้ยง USB มากกว่าการแย่ง bandwidth ระหว่างข้อมูล LiDAR, Arduino และ touch
