AungpaoK/EmbeddedProj/TestModules/TestMotor/TestMotor.ino

#include "robotconfig.h"

void driveMotors(int leftPWM, int rightPWM) {
  // --- Left Motor ---
  int pwmL = constrain(abs(leftPWM), 0, 255);
  if (leftPWM > 0) {
    digitalWrite(IN3, HIGH); digitalWrite(IN4, LOW);
  } else if (leftPWM < 0) {
    digitalWrite(IN3, LOW); digitalWrite(IN4, HIGH);
  } else {
    digitalWrite(IN3, LOW); digitalWrite(IN4, LOW);
  }
  // The physical left motor is connected to L298N bridge B.
  analogWrite(ENB, pwmL);

  // --- Right Motor ---
  int pwmR = constrain(abs(rightPWM), 0, 255);
  if (rightPWM > 0) {
    digitalWrite(IN1, LOW); digitalWrite(IN2, HIGH);
  } else if (rightPWM < 0) {
    digitalWrite(IN1, HIGH); digitalWrite(IN2, LOW);
  } else {
    digitalWrite(IN1, LOW); digitalWrite(IN2, LOW);
  }
  // The physical right motor is connected to L298N bridge A.
  analogWrite(ENA, pwmR);
}

// --- Diagnostic Test Function ---
void testL298N() {
  Serial.println("--- Starting L298N Motor Diagnostics ---");

  // 1. Forward Test
  Serial.println("1. Moving FORWARD (Speed: 180)");
  driveMotors(180, 180);
  delay(2000);
  driveMotors(0, 0);

  // 2. Reverse Test
  Serial.println("2. Moving REVERSE (Speed: 180)");
  driveMotors(-180, -180);
  delay(2000);
  driveMotors(0, 0);

  // 3. Spin Left
  Serial.println("3. Turning LEFT");
  driveMotors(-180, 180);
  delay(1500);
  driveMotors(0, 0);

  // 4. Spin Right
  Serial.println("4. Turning RIGHT");
  driveMotors(180, -180);
  delay(1500);
  driveMotors(0, 0);

  // 5. Stop
  Serial.println("5. BRAKE / STOP");
  driveMotors(0, 0);
  Serial.println("--- Diagnostic Test Complete ---");
}

void setup() {
  Serial.begin(115200);
  
  // Set Pins 8-13 as OUTPUTs using Register B or pinMode
  DDRB |= 0b00111111;

  // Run the motor test sequence once on power-up
  testL298N();
}

void loop() {
  // Motors remain stopped in loop after test completes
}
