AungpaoK/EmbeddedProj/(commit log)

2026-09-11 Edit Encoder pins
2026-09-15 improves PID
2026-09-16 Add motor debug file
2026-09-16 add odometry code for raspberrypi
2026-09-16 update wheelbase size
2026-09-16 feat: implement core control system and arduino firmware for food delivery robot
2026-09-16 feat: add delivery state machine with sensors and display
2026-09-17 fix: correct encoder direction logic and update ticks per revolution
    [TestEncoder.ino, robotconfig.h]
2026-09-18 feat: add Keypad For arduino 1
2026-09-18 feat: update Arduino modules and hardware controls
2026-09-19 refactor: simplify PID controller logic by removing matrix display and mission sequencing
2026-09-19 fix: correct encoder pin configurations and speed filter implementation alongside documentation and report additions
    [TestEncoder.ino]
2026-09-19 feat: add wheel speed synchronization, fix encoder direction, and include project documentation and reports
    [TestEncoder.ino]
2026-09-19 fix: correct motor pin mappings, tune PID parameters, and add project documentation and reports
    [TestMotor.ino]
2026-09-19 refactor: update left motor encoder pins to A2 and A3
2026-09-19 refactor: update debug print to output atomic left and right encoder ticks
2026-09-19 feat: implement continuous velocity control, waypoint navigation, and LiDAR safety guard
2026-09-19 fix: import MotionClient directly and add future annotations in waypoint_controller
    [waypoint_controller.py]
2026-09-19 fix(slam): broadcast full TF tree (base_footprint, base_link, laser) and add slam_toolbox_config.yaml
    [slam_bridge.py]
2026-09-19 fix(slam): invert linear velocity and odometry so i moves forward
    [slam_bridge.py]
2026-09-19 fix(slam): invert angular odometry and add travel thresholds for map updates
    [slam_bridge.py]
2026-09-19 fix(odom): fix encoder sign mismatch causing straight motion to cancel to 0 and spin
    [slam_bridge.py]
2026-09-19 fix(arduino): update Left Encoder pins to A3 (PC3) and A2 (PC2) matching robotconfig.h
    [Arduino_1_Motion.ino]
2026-09-19 refactor(arduino): bind all encoder and motor pins directly to robotconfig.h
2026-09-19 fix(odom): set INVERT_RIGHT_ENC=0 so forward motion does not swap with rotation
    [slam_bridge.py]
2026-09-19 fix(slam): separate steer vs odom yaw inversion, add 6WD skid factor and spike filter
    [slam_bridge.py]
2026-09-19 fix(tf): use sendTransform instead of sendTransforms for StaticTransformBroadcaster
    [slam_bridge.py]
2026-09-19 fix(explorer): increase chassis clearance to 0.22m to filter robot frame pillars
    [auto_explorer.py, lidar_safety.py, main.py]
2026-09-19 feat(scripts): add stop_auto_slam.sh to safely stop auto SLAM session and motors
2026-09-19 fix(explorer): add missing import os and sys
    [auto_explorer.py]
2026-09-19 fix(scenario): resolve Real Robot Mode motion freeze and bridge auto-startup
    - Separate /odom and static TF responsibilities between sim and robot mode in scenario_runner.py
    - Add incremental angular displacement tracking to prevent 180-deg wrap-around infinite loops
    - Add stall detection and timeout watchdogs to drive_forward and turn_degrees
    - Auto-launch slam_bridge.py on Raspberry Pi when selecting Real Robot Mode in start_scenario.sh
    - Add stop_scenario.sh for safe emergency stop
    [scenario_runner.py]
2026-09-19 fix(ros2): guard rclpy.shutdown on KeyboardInterrupt to prevent RCLError
    [scenario_runner.py, slam_bridge.py]
2026-09-19 fix(rviz): mount fastdds_peers.xml into docker, add periodic map publish, and guard stop_robot
    [scenario_runner.py]
2026-09-19 fix(odometry): correct yaw inversion in slam_bridge, implement closed-loop turn control and room scale options
    - Set default INVERT_ODOM_YAW to 1 in slam_bridge.py to ensure left turns produce positive yaw
    - Upgrade turn_degrees to closed-loop heading control with ±5 deg threshold
    - Add safety abort in scenario execution if motion/turn stalls
    - Add room scale options (2.0m standard vs 1.0m compact) in start_scenario.sh and config.py
    [config.py, scenario_runner.py, slam_bridge.py]
2026-09-20 Fix motion Arduino serial configuration
    [config.py, slam_bridge.py]
2026-09-20 fix(slam): calibrate tank turn odometry yaw
    [slam_bridge.py]
2026-09-20 fix(slam): align odometry yaw with robot rotation
    [slam_bridge.py]
2026-09-20 feat(slam): filter lidar returns from robot footprint
2026-09-20 Set explicit LiDAR and Arduino serial ports
2026-09-22 Show filtered lidar scan in RViz
2026-09-22 Filter robot self returns in auto SLAM
2026-09-22 Align lidar yaw with robot footprint
2026-09-22 Increase auto escape motor speed
2026-09-22 Adapt auto drive speed from encoder motion
2026-09-23 Add .env example file and update scripts to load environment variables
    - Created .env.example with Raspberry Pi IP address and optional settings.
    - Updated run_rviz2_pc.sh, start_auto_slam.sh, start_scenario.sh, and start_slam.sh to source the .env file for environment variables.
    - Introduced env_loader.py to handle loading of environment variables.
2026-09-23 fix: update motion serial baud configuration to use environment variable
    [config.py]
2026-09-23 Fix Arduino baud propagation into tmux
    [config.py]
2026-09-23 Fix real robot scenario turn direction
    [scenario_runner.py]
2026-09-23 Add bounded encoder-based motor stall ramp
    [Arduino_1_Motion.ino, slam_bridge.py]
2026-09-23 Require valid encoder stream before robot motion
2026-09-24 feat: add ROS 2 support for motion and odometry, update environment variables, and enhance Firefox kiosk mode
2026-09-24 feat: implement Arduino serial startup helpers and integrate with SLAM Bridge
2026-09-24 Add motor-safe turn indicator test mode
2026-09-24 Cycle turn signal demo without motor input
2026-09-24 fix: disable turn indicator demo mode for proper functionality
    [robotconfig.h]
2026-09-24 feat: update XWayland authorization handling to read current cookie path dynamically
2026-09-24 Move turn indicator control to Raspberry Pi
2026-09-25 Improve POS kiosk and add mission reset
    [delivery_fsm.py, pos_server.py]
2026-09-25 feat: Implement restaurant visualization and fixed-route delivery controller
    - Add `restaurant_visualizer.py` to publish static restaurant layout and robot path for RViz2.
    - Update `scenario_runner.py` to correct angular velocity commands for robot movement.
    - Refactor `waypoint_controller.py` to manage fixed delivery routes with odometry feedback.
    - Enhance `start_robot.sh` to include visualization and console commands for mission control.
    - Modify `start_scenario.sh` to adjust steering inversion settings for robot navigation.
    - Update tests for delivery FSM and POS server to accommodate new waypoint controller logic.
    - Introduce `test_waypoint_controller.py` for unit testing waypoint navig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
    [delivery_fsm.py, main.py, pos_console.py, restaurant_visualizer.py, scenario_runner.py]
2026-09-25 fix: update LIDAR stop distance to 0.30 meters in configuration and main logic
    [lidar_safety.py, main.py]
2026-09-25 Swap shelf mapping and delay after pickup
    [delivery_fsm.py, pos_server.py]
2026-09-26 Update operation scenarios and setup documentation for food delivery robot
    - Revised the operation scenarios in `scenario.md` to clarify the robot's navigation and task execution processes, including detailed descriptions of the restaurant layout, waypoint navigation, and mission control via POS/Kiosk and Keypad.
    - Enhanced the setup instructions in `setup.md` to reflect the updated hardware configuration, including the use of Raspberry Pi 4, Arduino Uno R3, RPLIDAR, and a 7-inch touch screen POS/Kiosk.
    - Adjusted references to configuration files and clarified the initial coordinates for the robot's operation.
    - Improved the explanation of button functionalities and system responses during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
2026-09-26 Reassert turn indicator state to Arduino
2026-09-26 Skip LiDAR stop check during in-place turns
    [waypoint_controller.py]
2026-09-27 feat: add turn indicator demo mode and remove legacy PID and ROS2 odometry code
2026-09-28 feat: add TestI2CScanner Arduino sketch to scan for I2C devices
2026-09-28 refactor: expand robot configuration and update turn indicator with software SPI and phased animations
2026-09-28 refactor: replace static TF broadcaster with dynamic map-odom TF publishing
    [restaurant_visualizer.py]
2026-09-28 feat: add interactive wheel-odometry calibration tests for the real robot
2026-09-28 feat: add table stop tolerance and enhance waypoint controller for parking pose handling
    [config.py, waypoint_controller.py]
2026-09-28 Refactor SLAM Bridge and Waypoint Controller for improved odometry and navigation
    - Updated SLAM Bridge to use constants for tick scaling and odometry track width factor.
    - Enhanced logging in SLAM Bridge to include tick counts in odometry messages.
    - Refactored Waypoint Controller to support cross-track control with configurable gains.
    - Introduced new methods for driving to waypoints with improved error handling and telemetry.
    - Added tests for cross-track correction and waypoint navigation requirements.
    - Cleaned up environment variable usage in startup scripts for consistency.
    [config.py, odometry.py, odometry_calibration_test.py, scenario_runner.py, slam_bridge.py, waypoint_controller.py]
